reeenatamc/feuoir-interface/mediciones/2026-09-19-piso-con-guitarra-2/captura.png

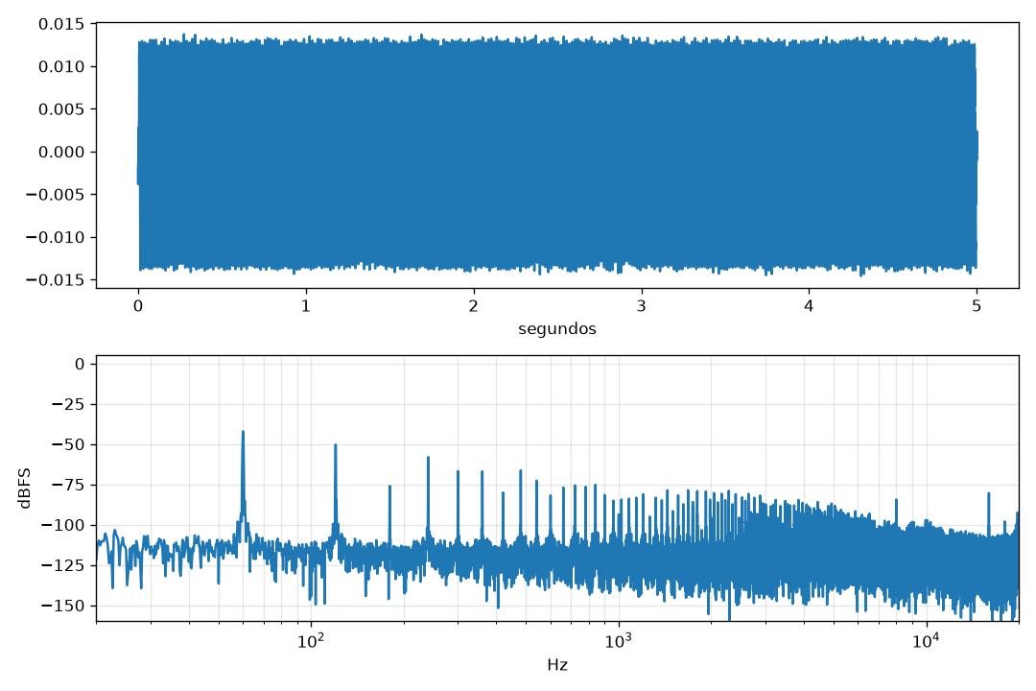
mediciones/2026-09-19-piso-con-guitarra-2/captura.png
