reeenatamc/feuoir-interface/mediciones/2026-09-19-piso-tarjeta-al-aire-3/captura.png

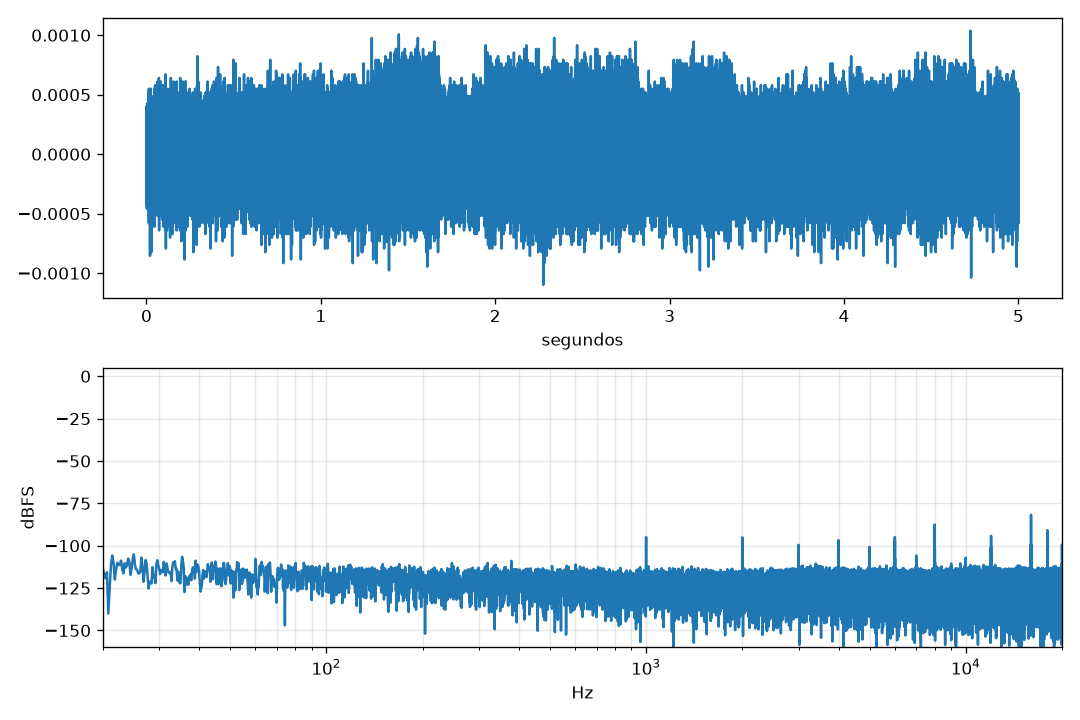
mediciones/2026-09-19-piso-tarjeta-al-aire-3/captura.png
