reeenatamc/feuoir-interface/mediciones/2026-09-19-piso-tarjeta-al-aire/captura.png

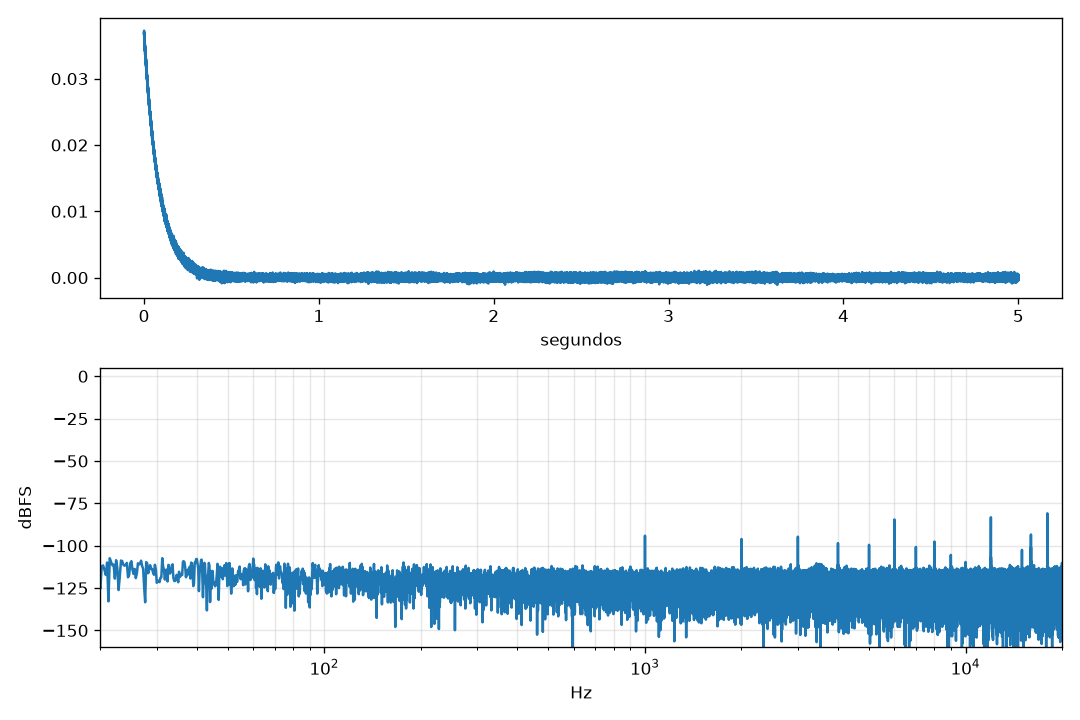
mediciones/2026-09-19-piso-tarjeta-al-aire/captura.png
