reeenatamc/feuoir-interface/mediciones/2026-09-19-rasgueo-fuerte-2/captura.png

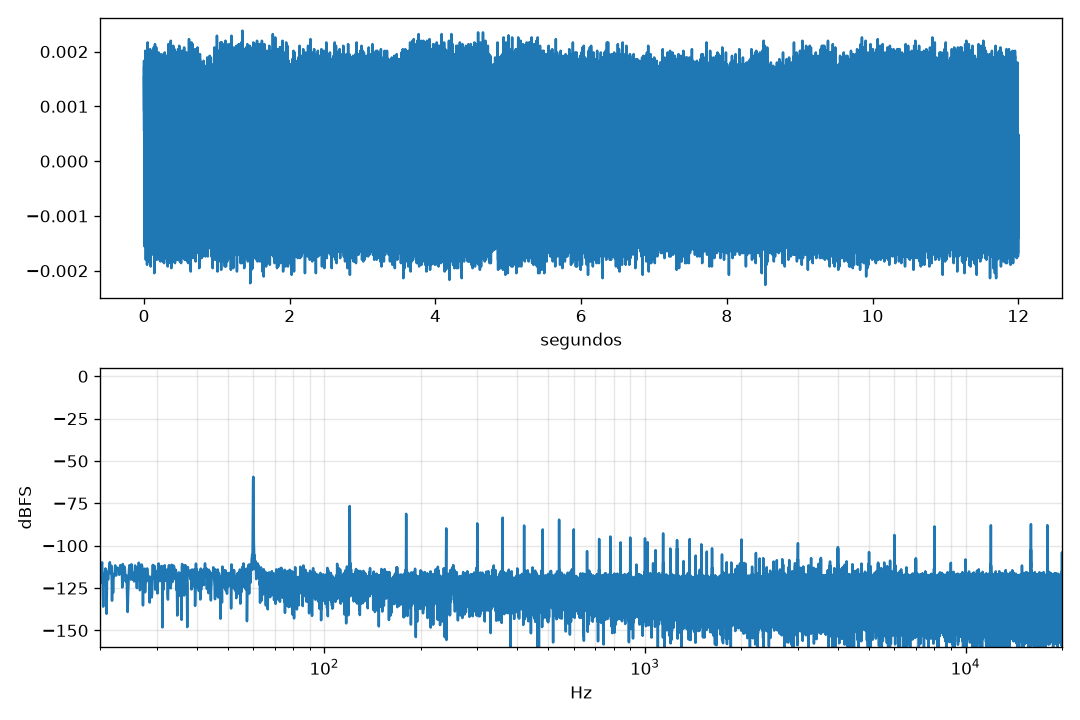
mediciones/2026-09-19-rasgueo-fuerte-2/captura.png
