reeenatamc/feuoir-interface/mediciones/2026-09-19-rasgueo-fuerte/captura.png

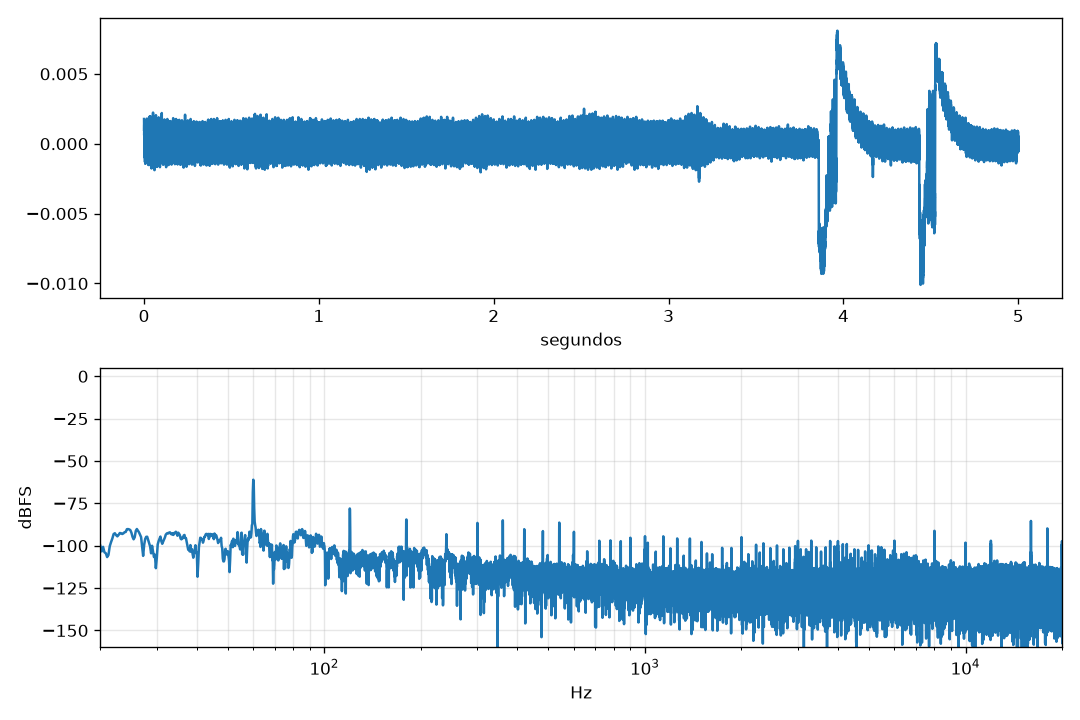
mediciones/2026-09-19-rasgueo-fuerte/captura.png
