reeenatamc/feuoir-interface/mediciones/2026-09-19-rasgueo-suave/captura.png

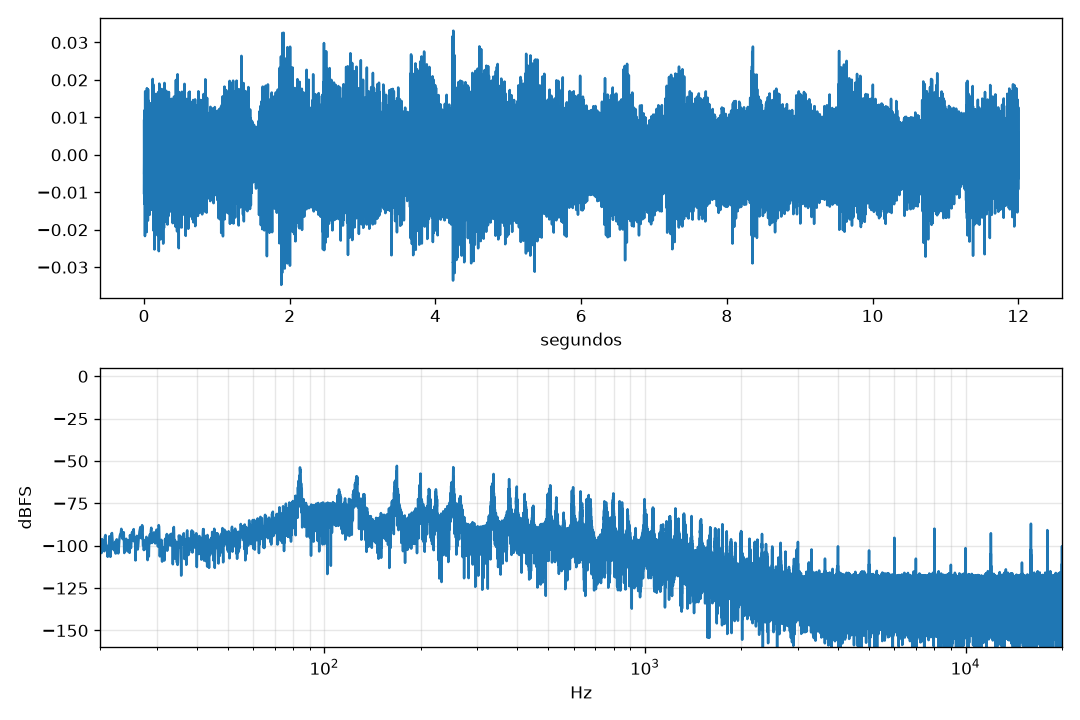
mediciones/2026-09-19-rasgueo-suave/captura.png
