reeenatamc/feuoir-interface/mediciones/2026-09-19-selector-4-con-golpes/captura.png

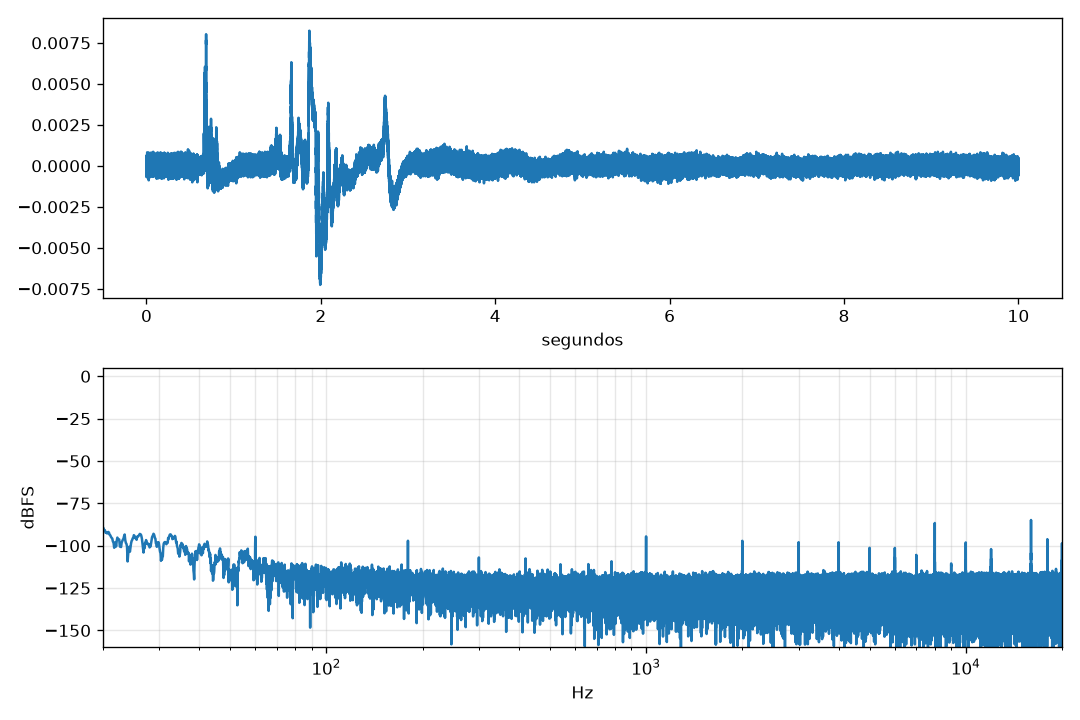
mediciones/2026-09-19-selector-4-con-golpes/captura.png
