reeenatamc/feuoir-interface/mediciones/2026-09-19-selector-5/captura.png

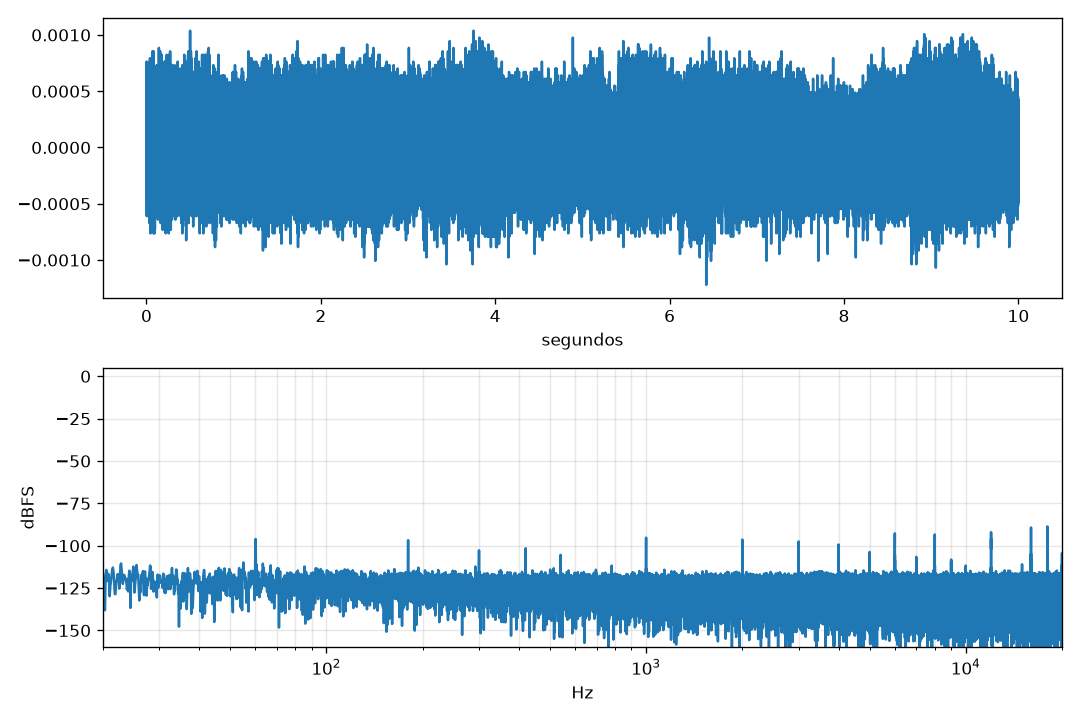
mediciones/2026-09-19-selector-5/captura.png
