reeenatamc/feuoir-interface/mediciones/2026-09-19-tono-usb-canal1-2/captura.png

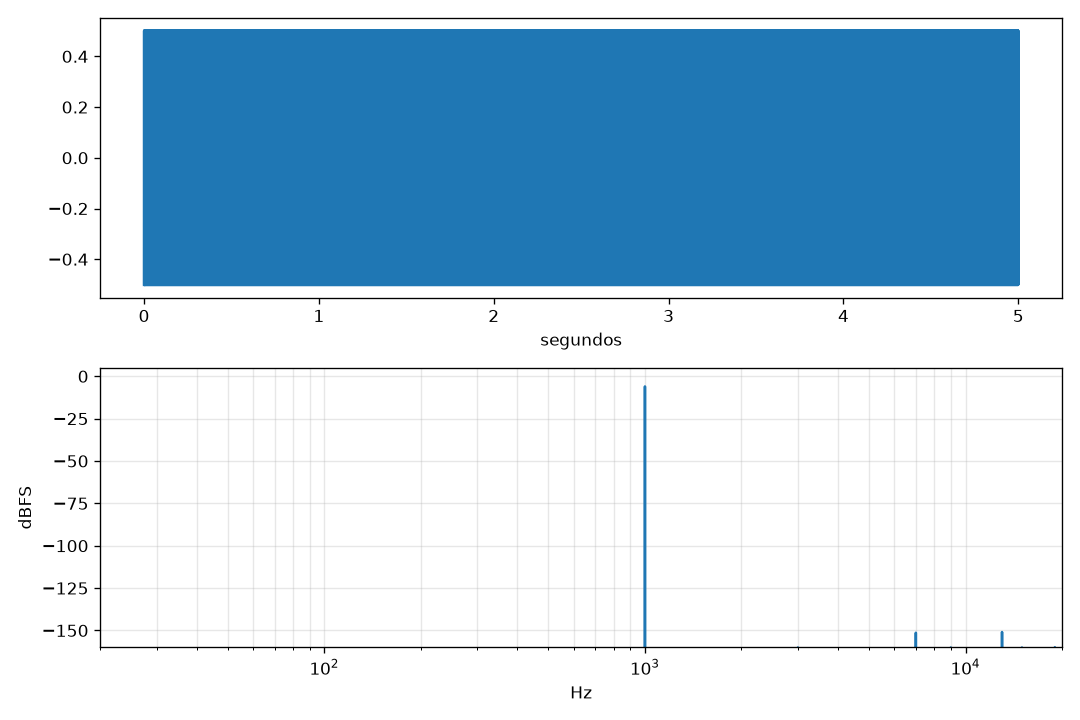
mediciones/2026-09-19-tono-usb-canal1-2/captura.png
