reeenatamc/feuoir-interface/mediciones/2026-09-19-tono-usb-canal2/captura.png

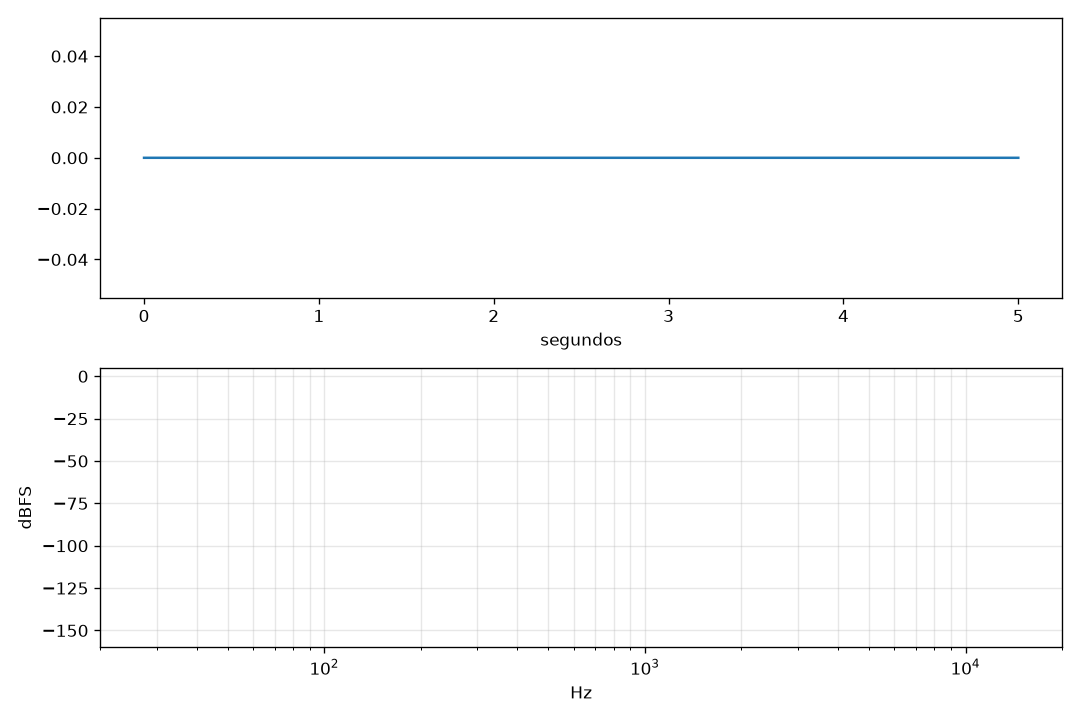
mediciones/2026-09-19-tono-usb-canal2/captura.png
