reeenatamc/feuoir-interface/mediciones/2026-09-19-toque-dulce/captura.png

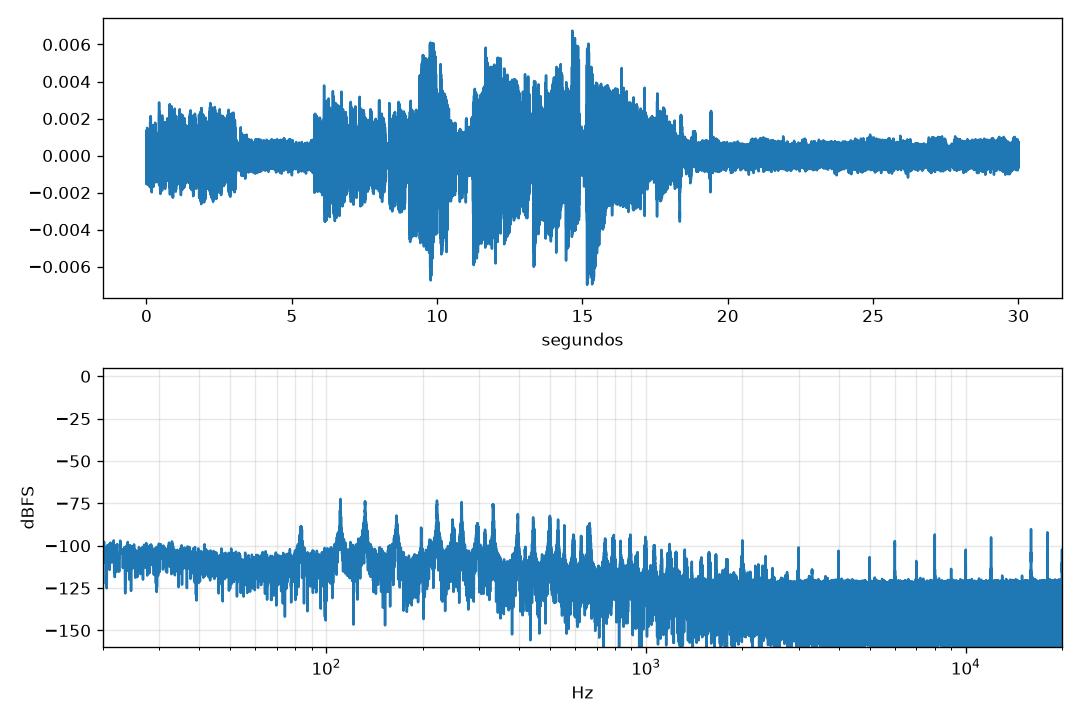
mediciones/2026-09-19-toque-dulce/captura.png
