reeenatamc/feuoir-interface/mediciones/2026-09-19-toque-libre/captura.png

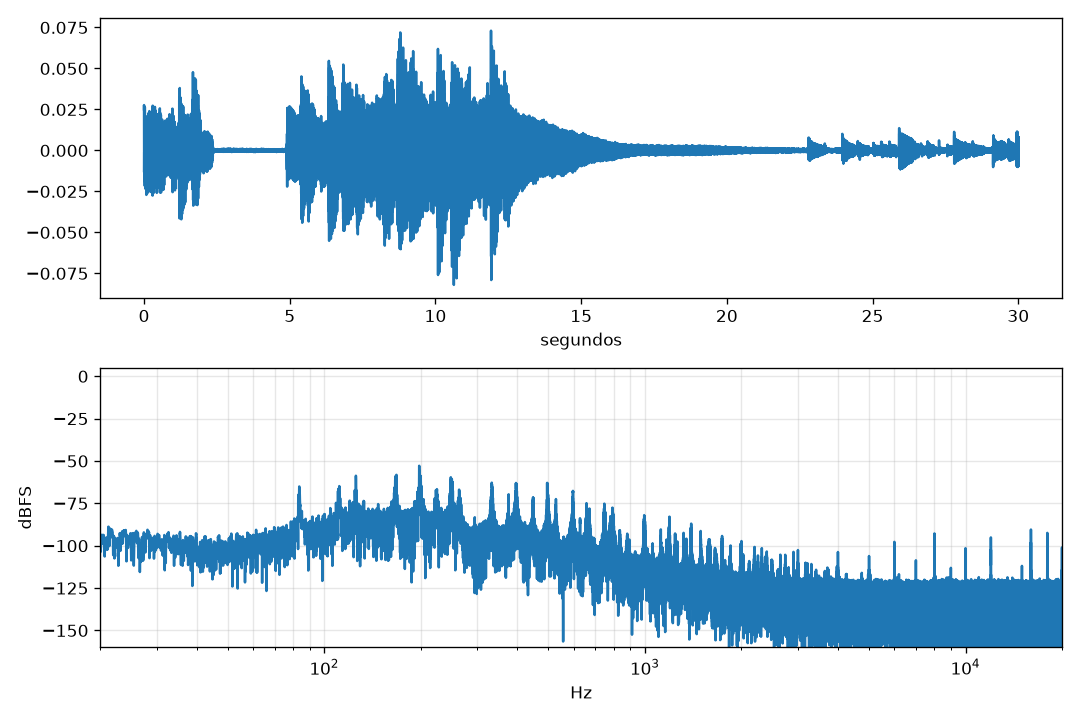
mediciones/2026-09-19-toque-libre/captura.png
