reeenatamc/feuoir-interface/mediciones/2026-09-23-sim-carga-guitarra/grafica.png

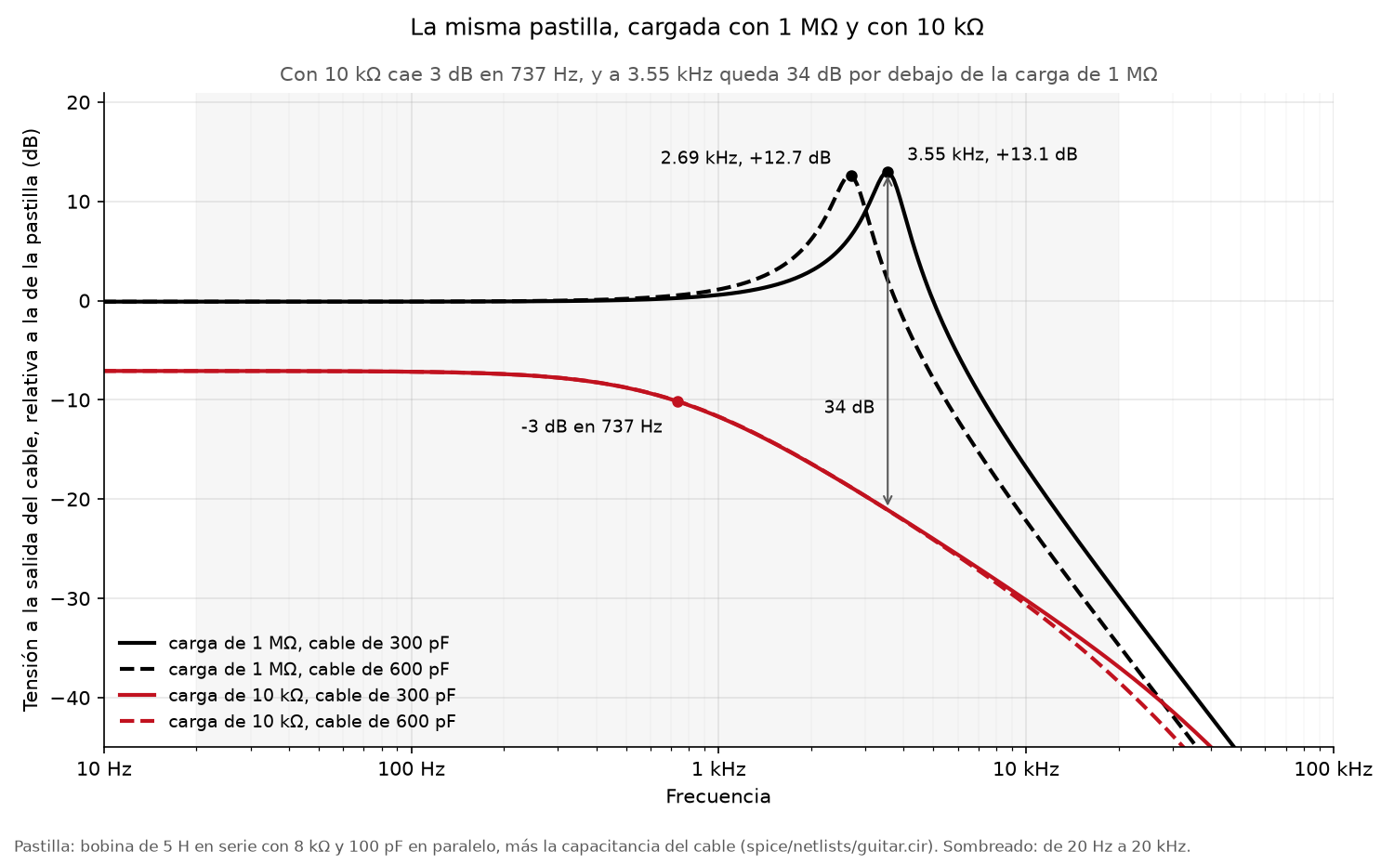
mediciones/2026-09-23-sim-carga-guitarra/grafica.png
