reeenatamc/feuoir-interface/mediciones/2026-09-23-sim-respuesta-en-frecuencia/grafica-partida.png

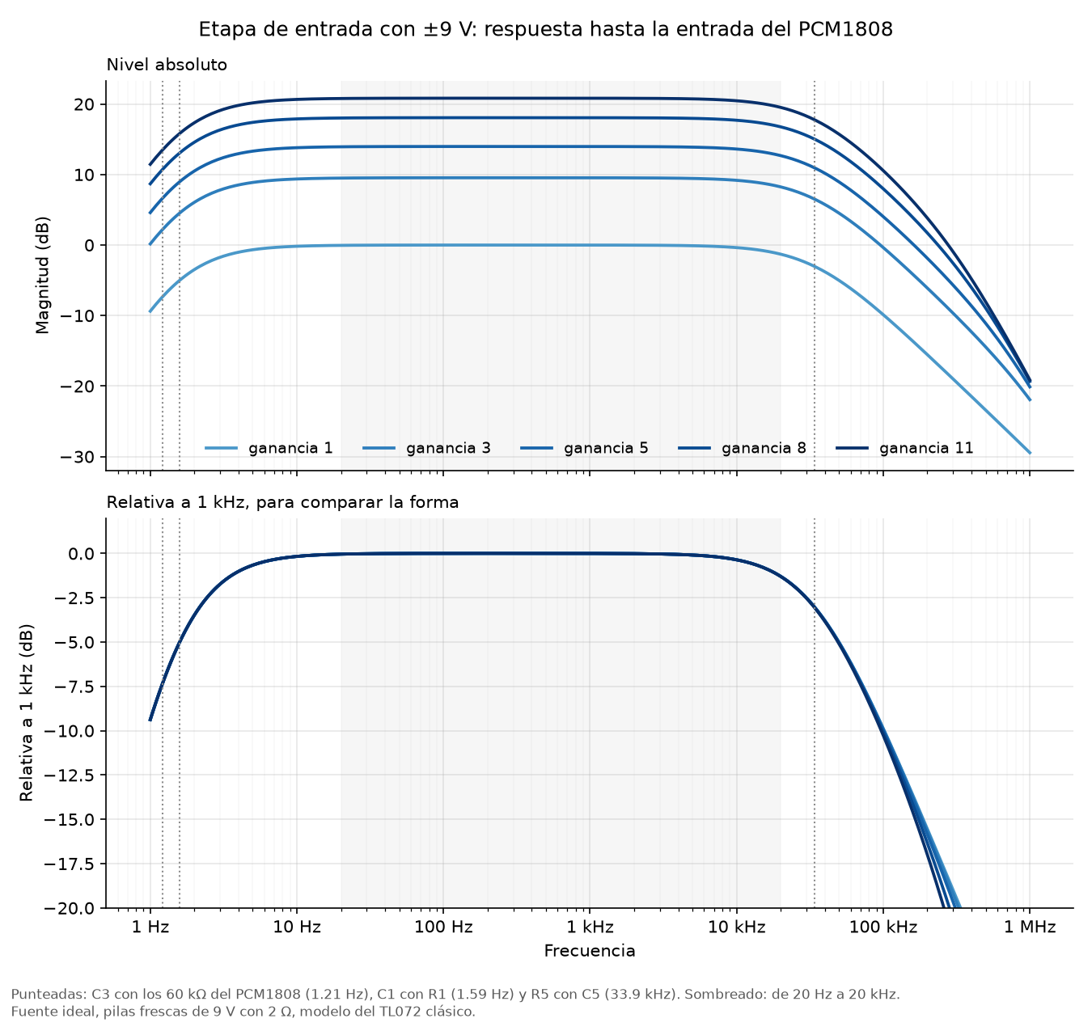
mediciones/2026-09-23-sim-respuesta-en-frecuencia/grafica-partida.png
