reeenatamc/feuoir-interface/mediciones/2026-09-23-sim-ruido/grafica.png

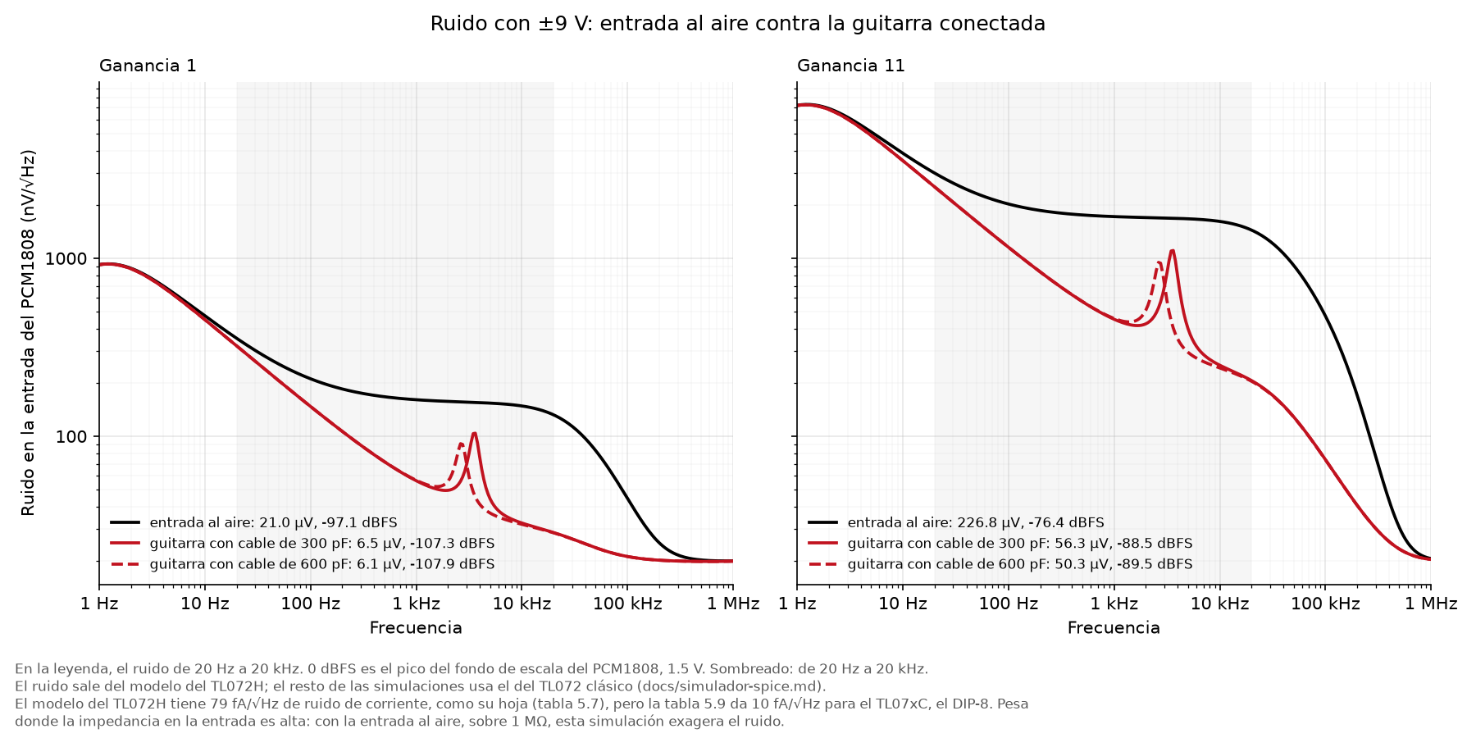
mediciones/2026-09-23-sim-ruido/grafica.png
