reeenatamc/feuoir-interface/mediciones/2026-09-23-sim-transitorio-1v5/grafica.png

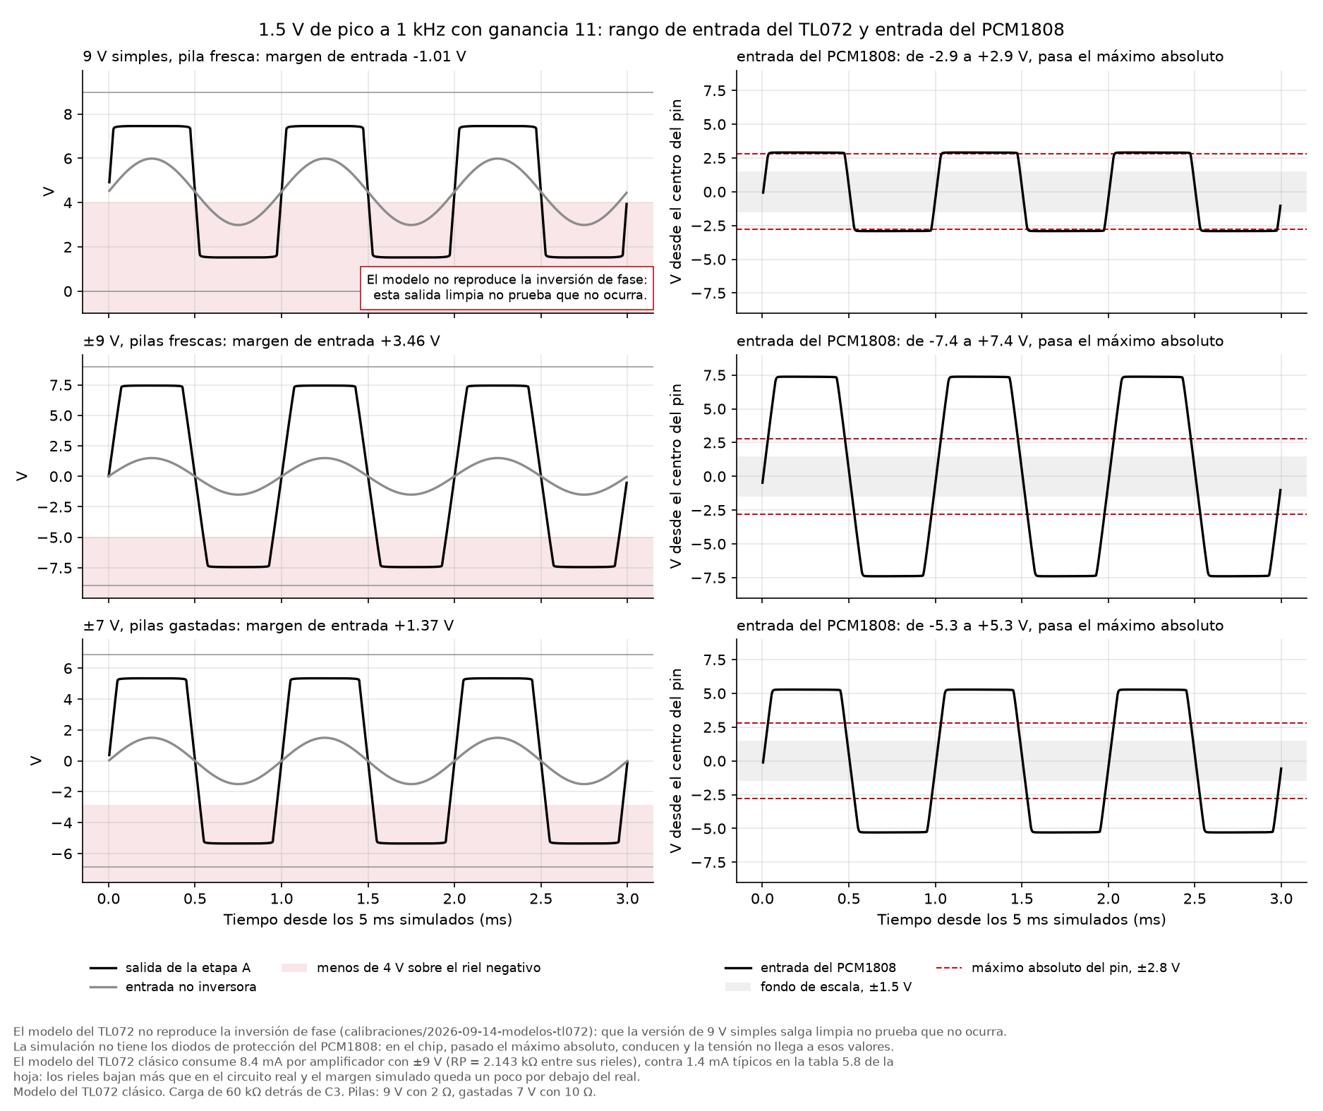
mediciones/2026-09-23-sim-transitorio-1v5/grafica.png
