reeenatamc/feuoir-interface/docs/armado/etapa_entrada_pasos.pdf

a b c d e | f g h i j

tierra

-9

tierra
+9

# Paso 1 de 21

## La piecita negra de ocho patitas

Pisando la zanja, patitas en las filas 14, 15, 16 y 17.

La muesca de media luna mira hacia el lado del 1.

Lo gris claro ya está puesto. Cuenta las filas desde la punta donde la tabla dice 1.

Los agujeritos de las cuatro tiras de los bordes no coinciden con los números: toda una tira es un mismo punto, así que en ellas sirve cualquier agujerito.

1

2

3

4 | 5
| 6

7

8

1 1

2 | 2
3 | 3
4 | 4
5 5
6 | 6
7 | 7
8 | 8
9 | 9
10 10
11 11
12 | 12
13 | 13
14 14
15 15
16 16
17 17
18 | 18
19 | 19
20 20
21 | 21
22 22
23 | 23
24 24
25 25
26 26
27 | 27
28 | 28
29 | 29
30 30

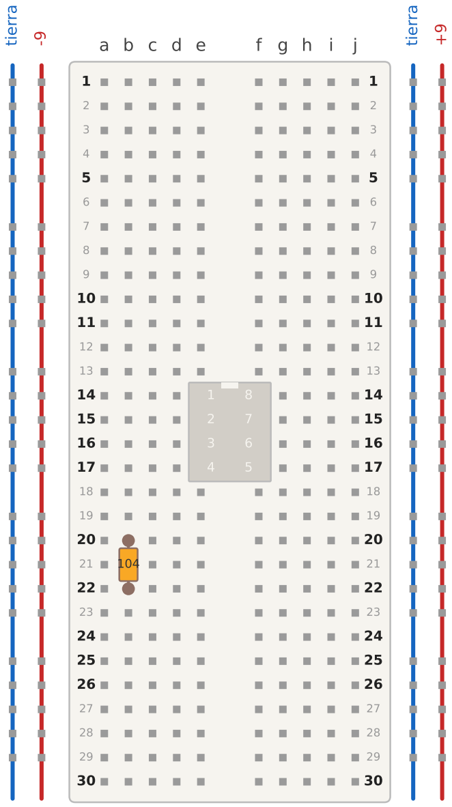
[picture p26: figure]
tierra

impreso en la cara

### así se ve la lentejita de este paso

# Paso 2 de 21

## Lentejita con 104 impreso

Una patita en b22 y la otra en b20.
No tiene lado, da igual cuál patita va en cuál.

104

a b c d e | f g h i j

tierra

-9

tierra
+9

café

negro

# negro amarillo

café

# si tiene 5 rayitas café negro verde dorada

si tiene 4 rayitas

### así se ve el tubito de este paso

# Paso 3 de 21

## Tubito de la tira que dice 1M

Una patita en c20 y la otra en c24.

No tiene lado.

1

2

3

4 | 5
| 6

7

8

1 1

2 | 2
3 | 3
4 | 4
5 5
6 | 6
7 | 7
8 | 8
9 | 9
10 10
11 11
12 | 12
13 | 13
14 14
15 15
16 16
17 17
18 | 18
19 | 19
20 20
21 | 21
22 22
23 | 23
24 24
25 25
26 26
27 | 27
28 | 28
29 | 29
30 30

a b c d e | f g h i j

tierra

-9

tierra
+9

café

negro

negro café
café

# si tiene 5 rayitas café negro rojo dorada

si tiene 4 rayitas

### así se ve el tubito de este paso

# Paso 4 de 21

## Tubito de la tira que dice 1K

Una patita en c15 y la otra en c11.

No tiene lado.

1

2

3

4 | 5
| 6

7

8

1 1

2 | 2
3 | 3
4 | 4
5 5
6 | 6
7 | 7
8 | 8
9 | 9
10 10
11 11
12 | 12
13 | 13
14 14
15 15
16 16
17 17
18 | 18
19 | 19
20 20
21 | 21
22 22
23 | 23
24 24
25 25
26 26
27 | 27
28 | 28
29 | 29
30 30

a b c d e | f g h i j

tierra

-9

tierra
+9

amarillo

violeta
negro café
café

# si tiene 5 rayitas amarillo violeta rojo dorada

si tiene 4 rayitas

### así se ve el tubito de este paso

# Paso 5 de 21

## Tubito de la tira que dice 4K7

Una patita en h20 y la otra en h24.

No tiene lado.

1

2

3

4 | 5
| 6

7

8

1 1

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

# Paso 6 de 21

## Lentejita con 102 impreso

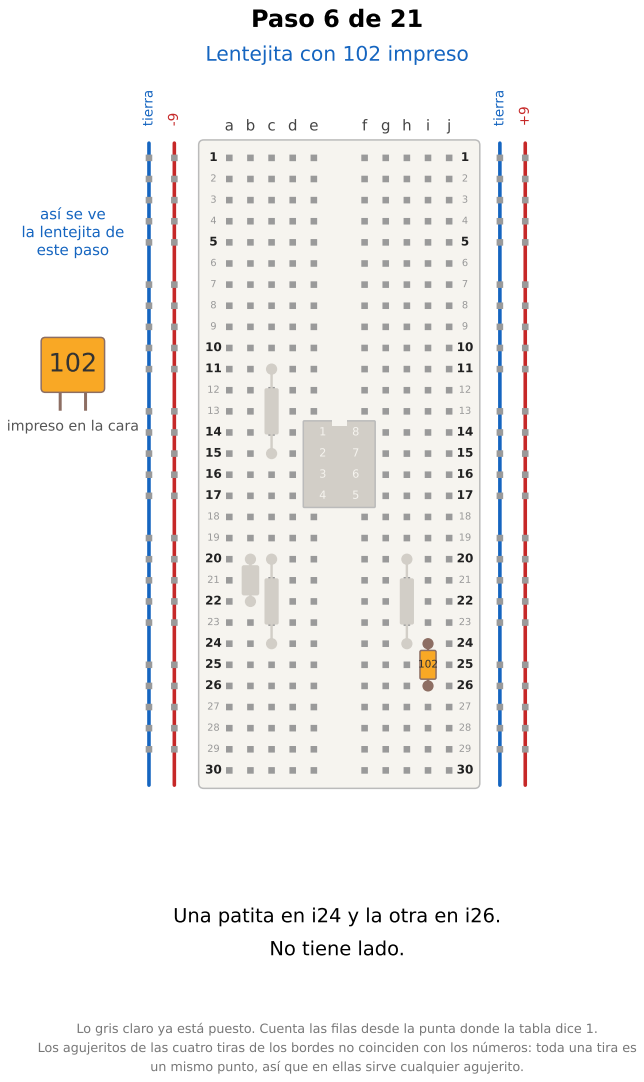
[picture p27: page 6]
tierra

así se ve
la lentejita de
este paso

impreso en la cara

Una patita en i24 y la otra en i26.

No tiene lado.

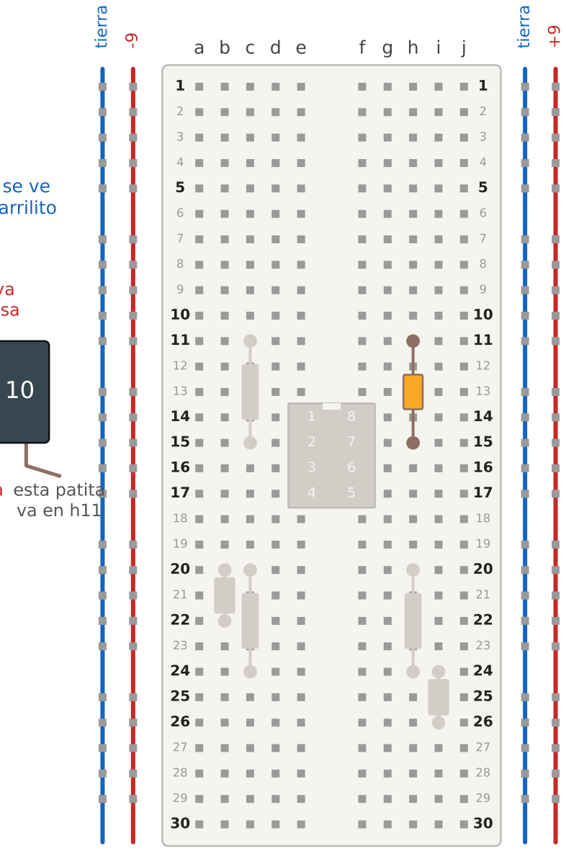
[picture p28: figure]
tierra; esta patita va en h11

esta patita
va en h15

la raya
impresa

### así se ve el barrilito

# Paso 7 de 21

## El barrilito de 10 µF

## Va de h15 a h11, y SÍ tiene lado: la patita del lado

de la raya impresa va en h15, la otra en h11.

# Paso 8 de 21

## Cable corto

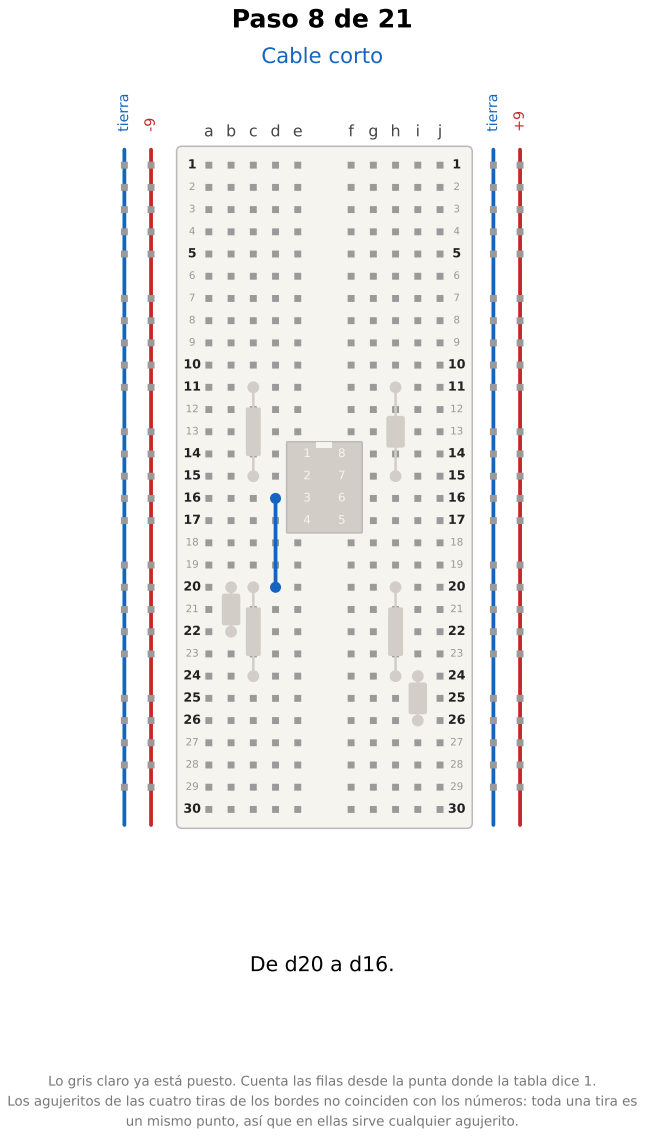
[picture p29: page 8]
tierra

# Paso 9 de 21

## Cable

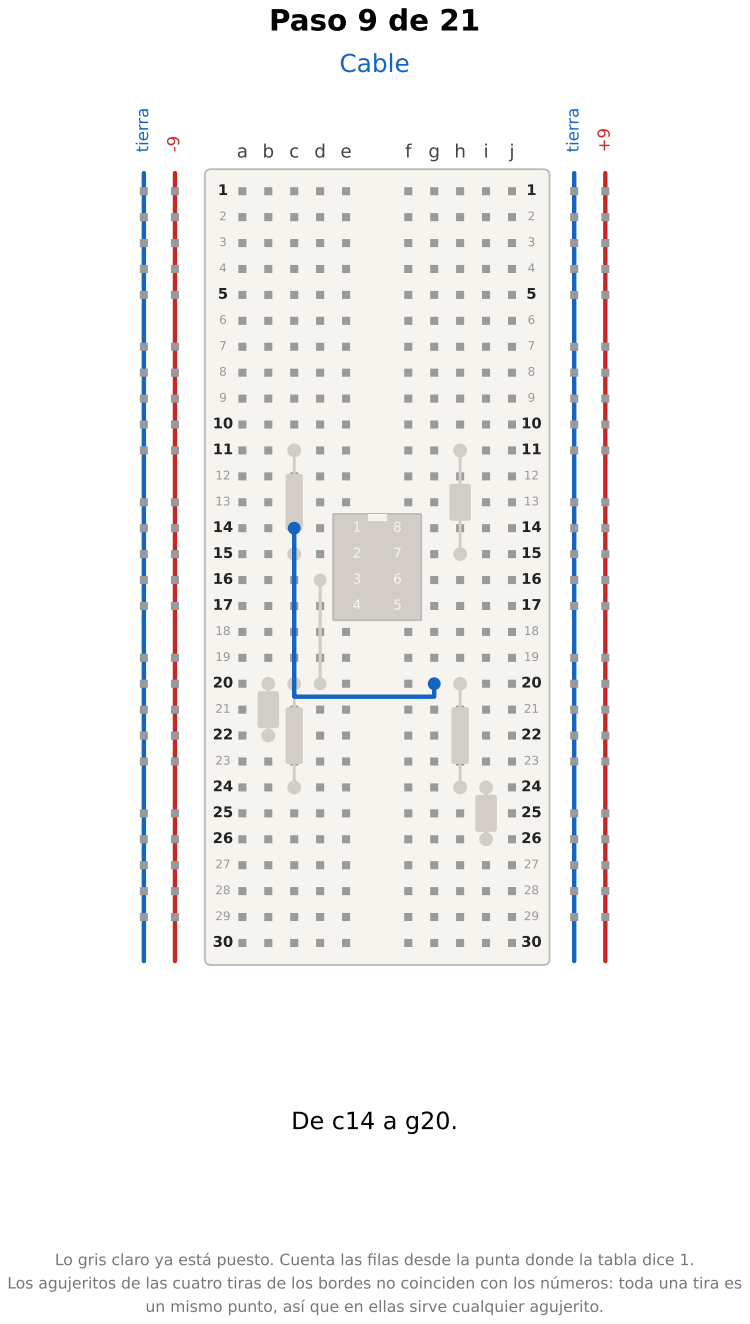
[picture p30: page 9]
tierra

# Paso 10 de 21

## Cable

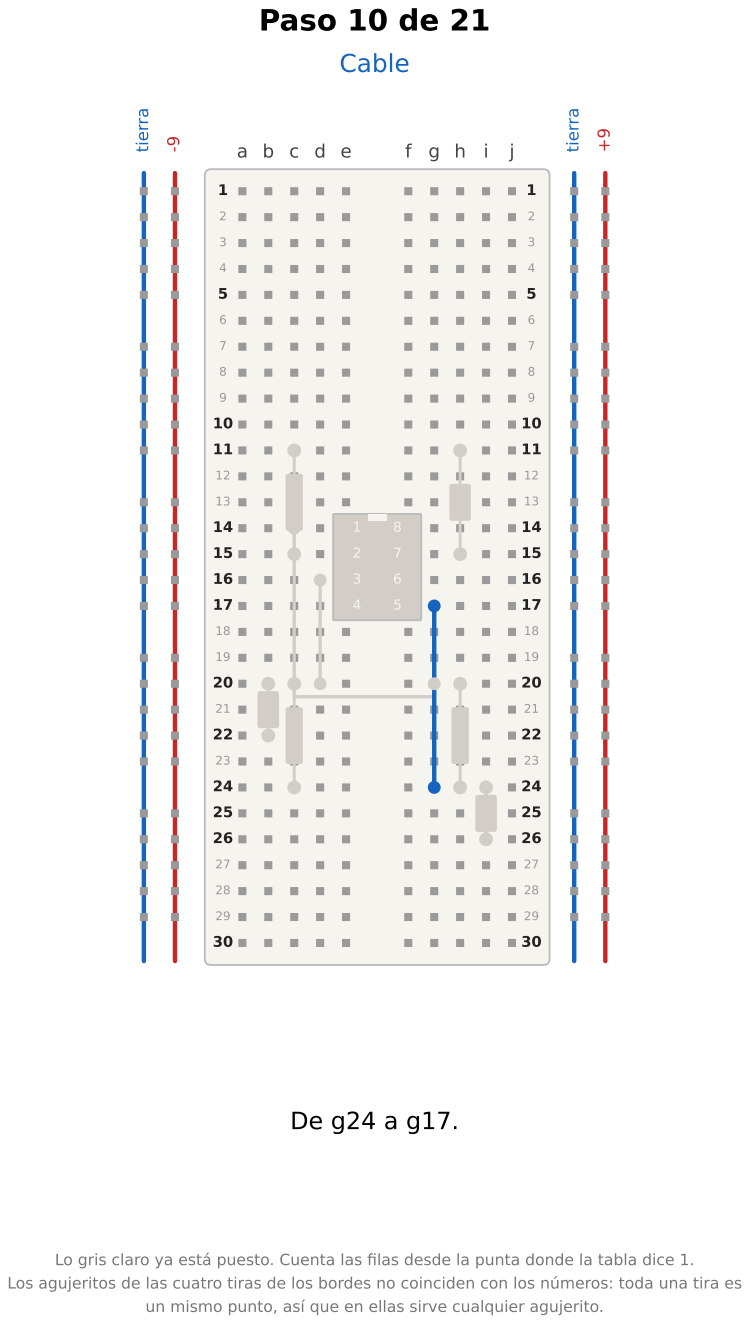
[picture p31: page 10]
tierra

# Paso 11 de 21

## Cable cortito

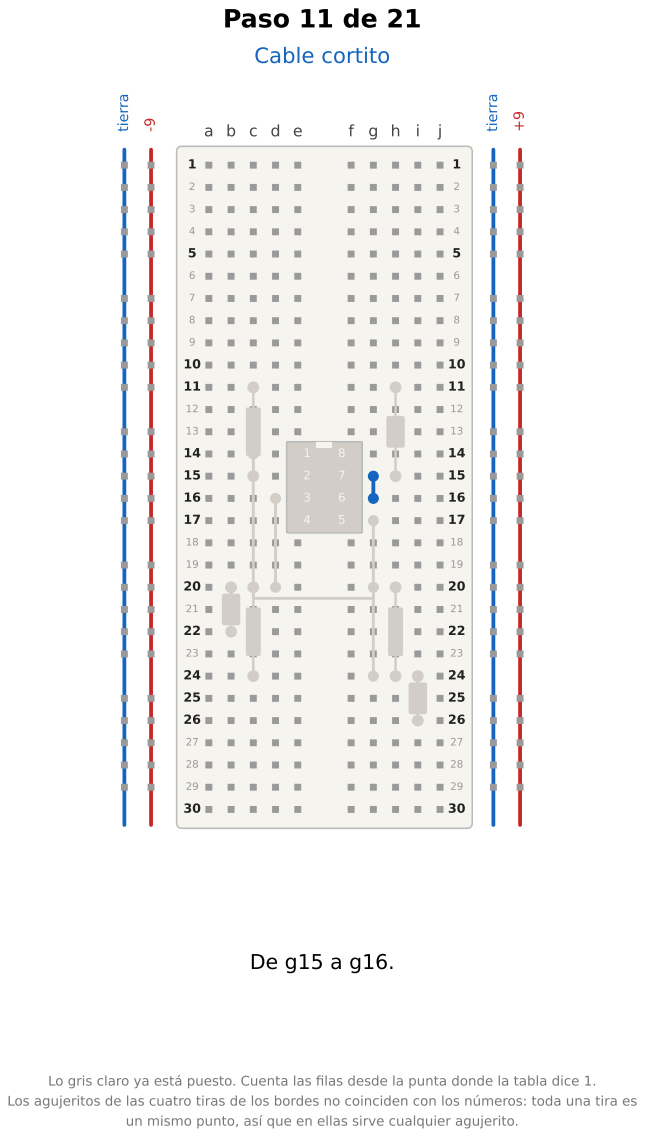
[picture p32: page 11]
tierra

a b c d e | f g h i j

tierra

-9

tierra
+9

# Paso 12 de 21

## Cable a una tira del borde

De a24 a la tira AZUL del lado de las letras a b c d e. Sirve cualquier agujerito de esa tira: usa uno cerca de la fila 24.

1

2

3

4 | 5
| 6

7

8

1 1

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

# Paso 13 de 21

## Cable a una tira del borde

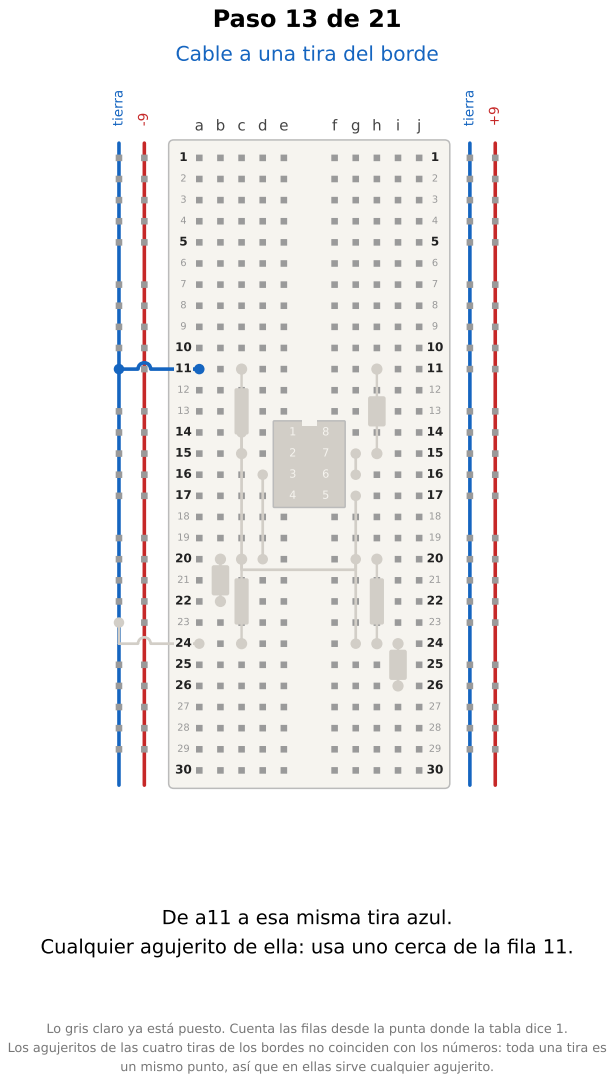
[picture p33: page 13]
tierra

De a11 a esa misma tira azul.

Cualquier agujerito de ella: usa uno cerca de la fila 11.

a b c d e | f g h i j

tierra

-9

tierra
+9

# Paso 14 de 21

## Cable a una tira del borde

De j26 a la tira AZUL del lado de las letras f g h i j. Cualquier agujerito de ella: usa uno cerca de la fila 26.

1

2

3

4 | 5
| 6

7

8

1 1

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

a b c d e | f g h i j

tierra

-9

tierra
+9

# Paso 15 de 21

## Cable a una tira del borde

De g14 a la tira ROJA del lado de las letras f g h i j. Cualquier agujerito de ella: usa uno cerca de la fila 14.

1

2

3

4 | 5
| 6

7

8

1 1

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

a b c d e | f g h i j

tierra

-9

tierra
+9

# Paso 16 de 21

## Cable a una tira del borde

De d17 a la tira ROJA del lado de las letras a b c d e. Cualquier agujerito de ella: usa uno cerca de la fila 17.

1

2

3

4 | 5
| 6

7

8

1 1

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

a b c d e | f g h i j

tierra

-9

tierra
+9

# Paso 17 de 21

## Cable largo que une las dos tiras de tierra

Un cable largo de una tira azul a la otra tira azul, por debajo de la tabla. Cualquier agujerito de cada una.

1

2

3

4 | 5
| 6

7

8

1 1

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

# Paso 18 de 21

## Dos lentejitas más con 104 impreso

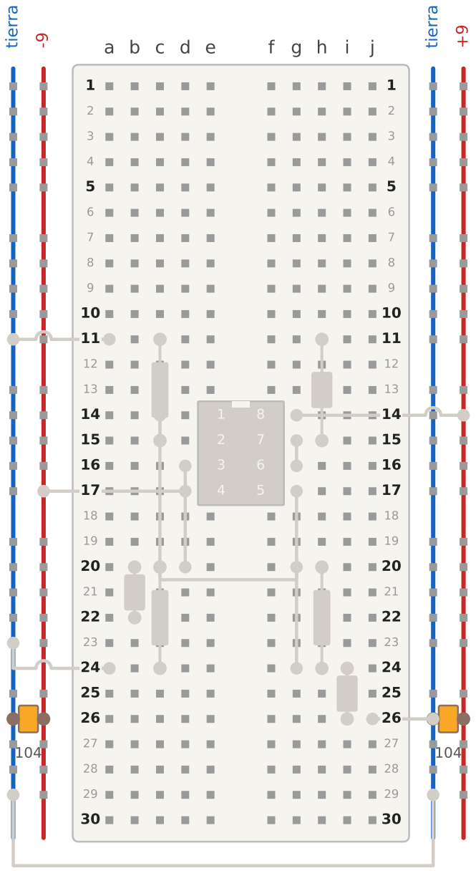
[picture p34: figure]
tierra

## Una con una patita en la tira roja y la otra en la azul

del mismo costado. Lo mismo con la otra, en el otro costado.

# Paso 19 de 21

## La perilla que gira, clavada en la tabla

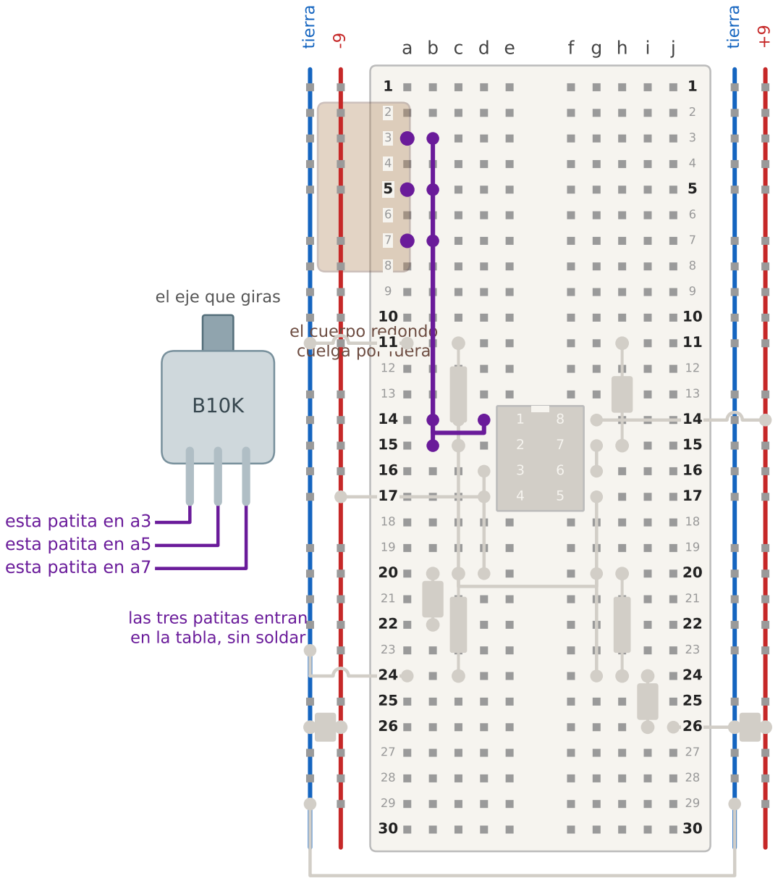
[picture p35: figure]
tierra; cuerpo redondo; cuelga por fuera; el eje que giras; esta patita en a3 esta patita en a5 esta patita en a7; las tres patitas entran en la tabla, sin soldar

## Sus tres patitas en a3, a5 y a7, con el cuerpo redondo colgando

hacia afuera de la tabla, para que no tape las letras b c d e.

## Luego tres cables: b3 a b14, b5 a d14 y b7 a b15. Si el cuerpo

tapa alguno, usa c, d o e de esa misma fila, es el mismo punto.

Si no quieres perilla: un tubito de a14 a b15 y nada más. Lo gris claro ya está puesto. Cuenta las filas desde la punta donde la tabla dice 1.

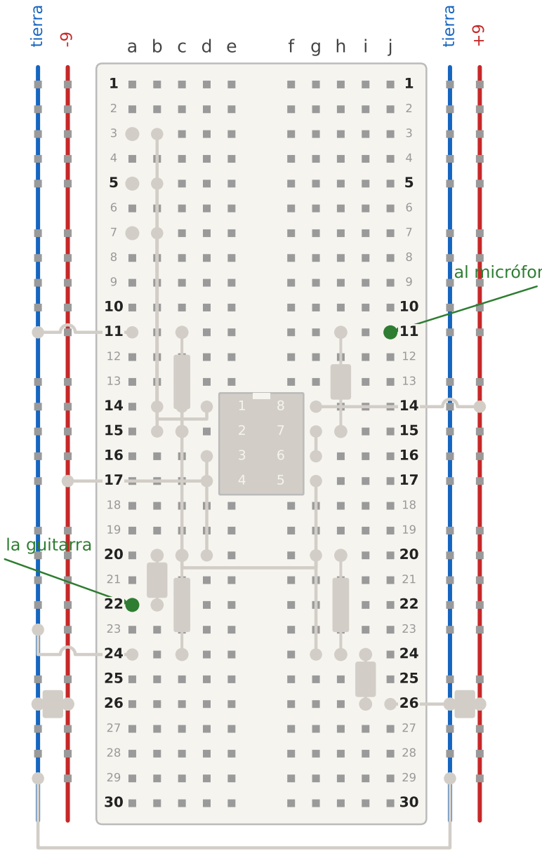
[picture p36: figure]
tierra

punta del cable de la guitarra al micrófono de la tarjeta USB

# Paso 20 de 21

## La guitarra entra y la señal sale

Vivo de la guitarra a a22, su malla a una tira de tierra. Salida j11 al cable de la tarjeta, su malla a tierra.

# Paso 21 de 21

## Las cajitas con pilas, AL FINAL Y APAGADAS

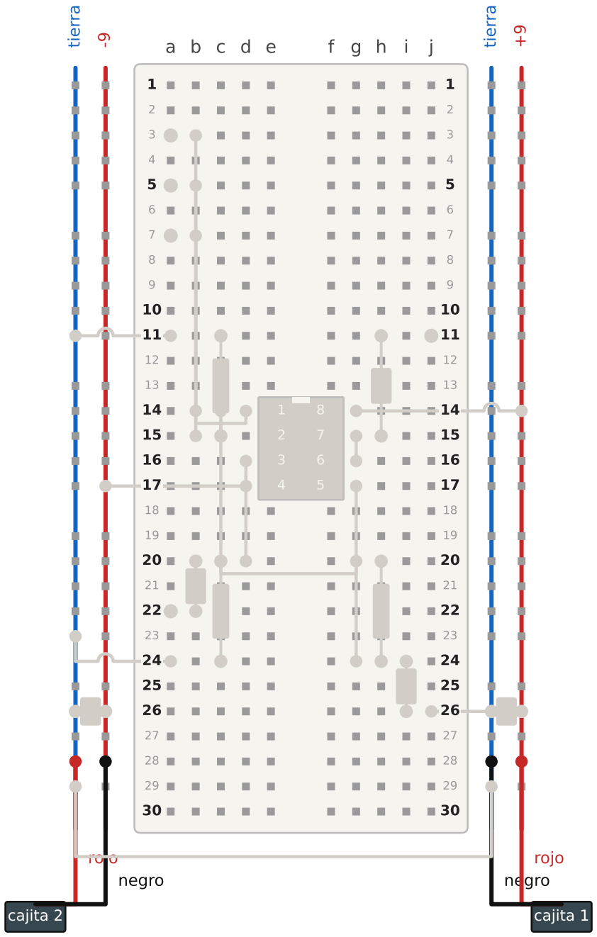
[picture p37: figure]
tierra; rojo; negro; cajita 2; cajita 1

Cajita 1: rojo a la tira de +9, negro a la tierra de ese lado. Cajita 2: rojo a la tierra del otro lado, negro a la de -9.
