reeenatamc/feuoir-interface/docs/armado/etapa2.png

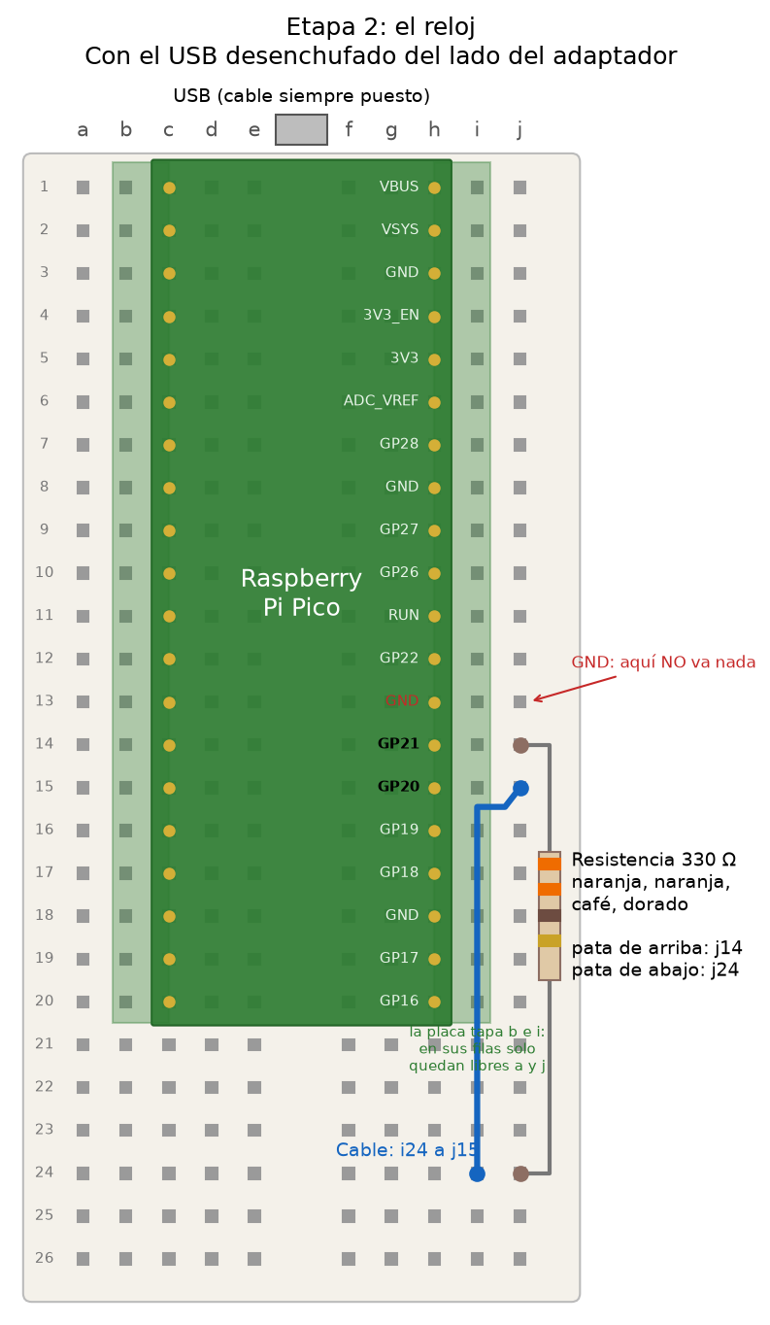
docs/armado/etapa2.png
