reeenatamc/feuoir-interface/docs/armado/etapa2_sobre_la_foto.jpg

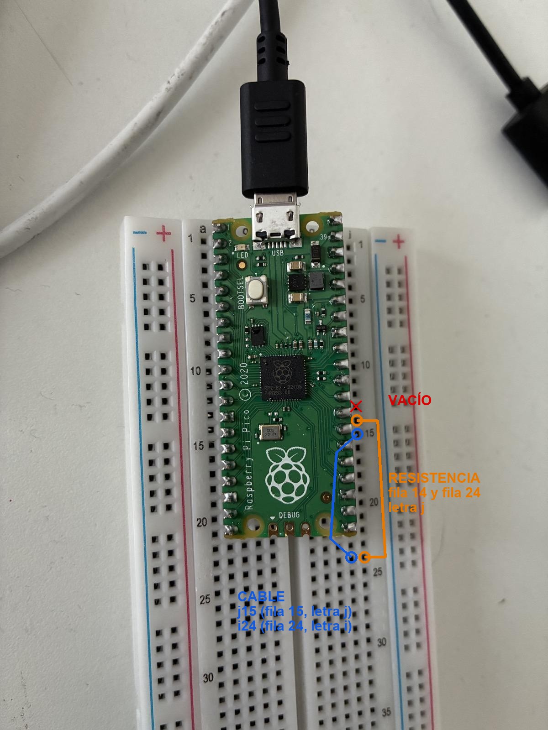
docs/armado/etapa2_sobre_la_foto.jpg
