reeenatamc/feuoir-interface/docs/armado/etapa_entrada_alimentacion.png

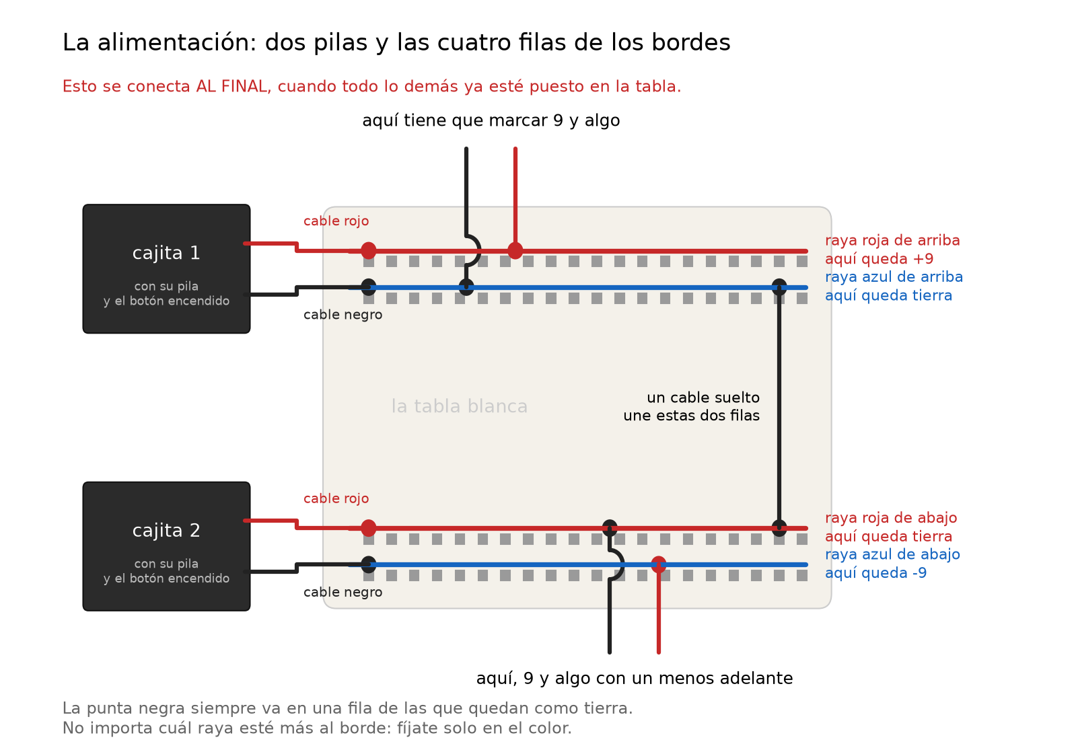
docs/armado/etapa_entrada_alimentacion.png
