reeenatamc/feuoir-interface/docs/armado/etapa_entrada_protoboard.png

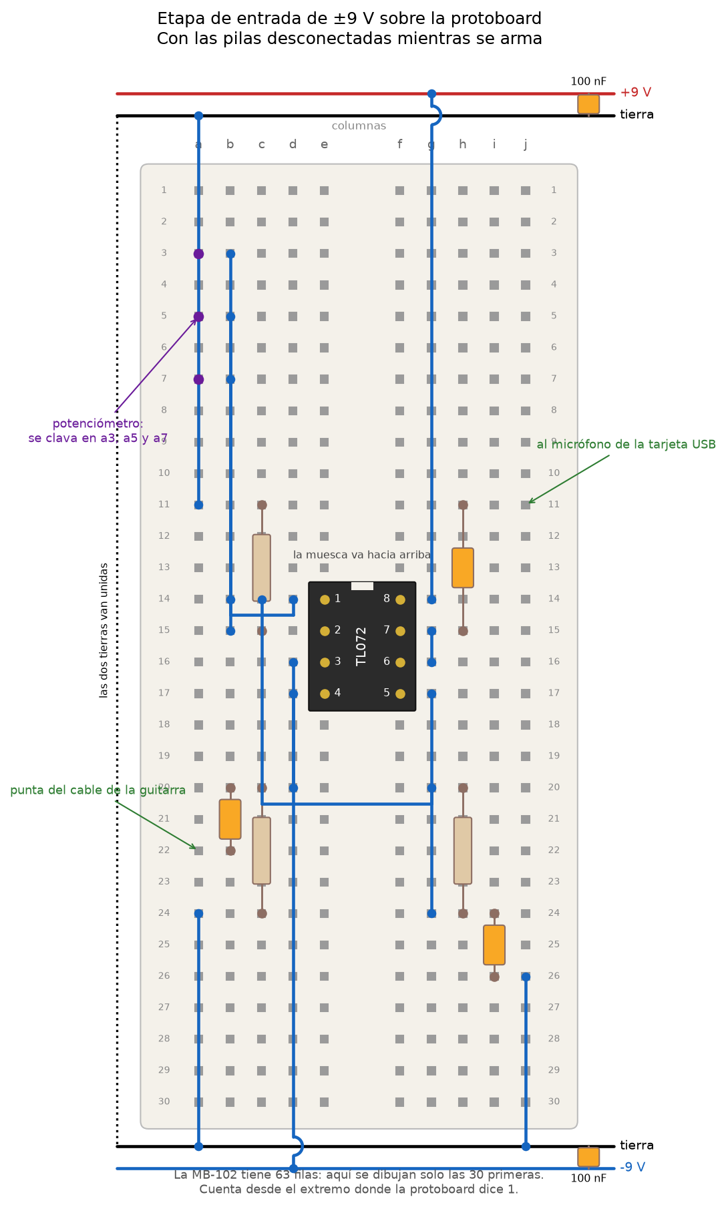
docs/armado/etapa_entrada_protoboard.png
