reeenatamc/feuoir-interface/docs/armado/pasos/paso_01.png

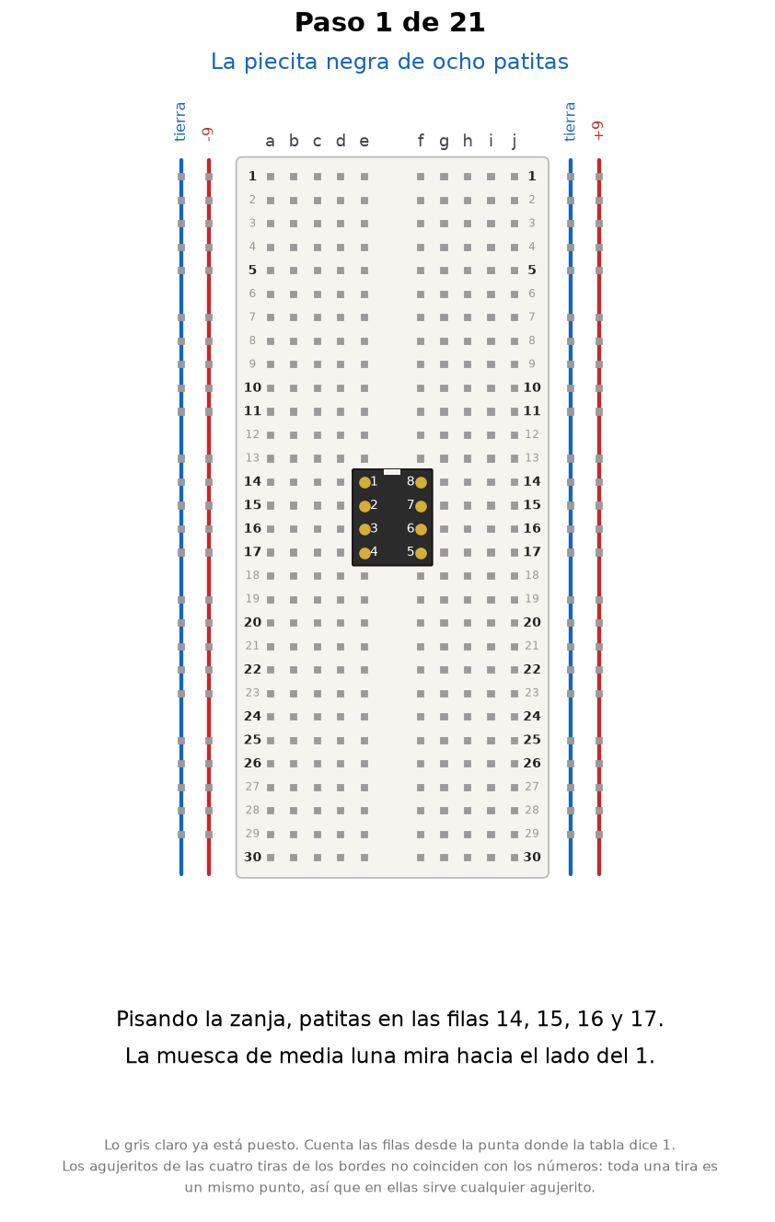
docs/armado/pasos/paso_01.png
