reeenatamc/feuoir-interface/docs/armado/pasos/paso_03.png

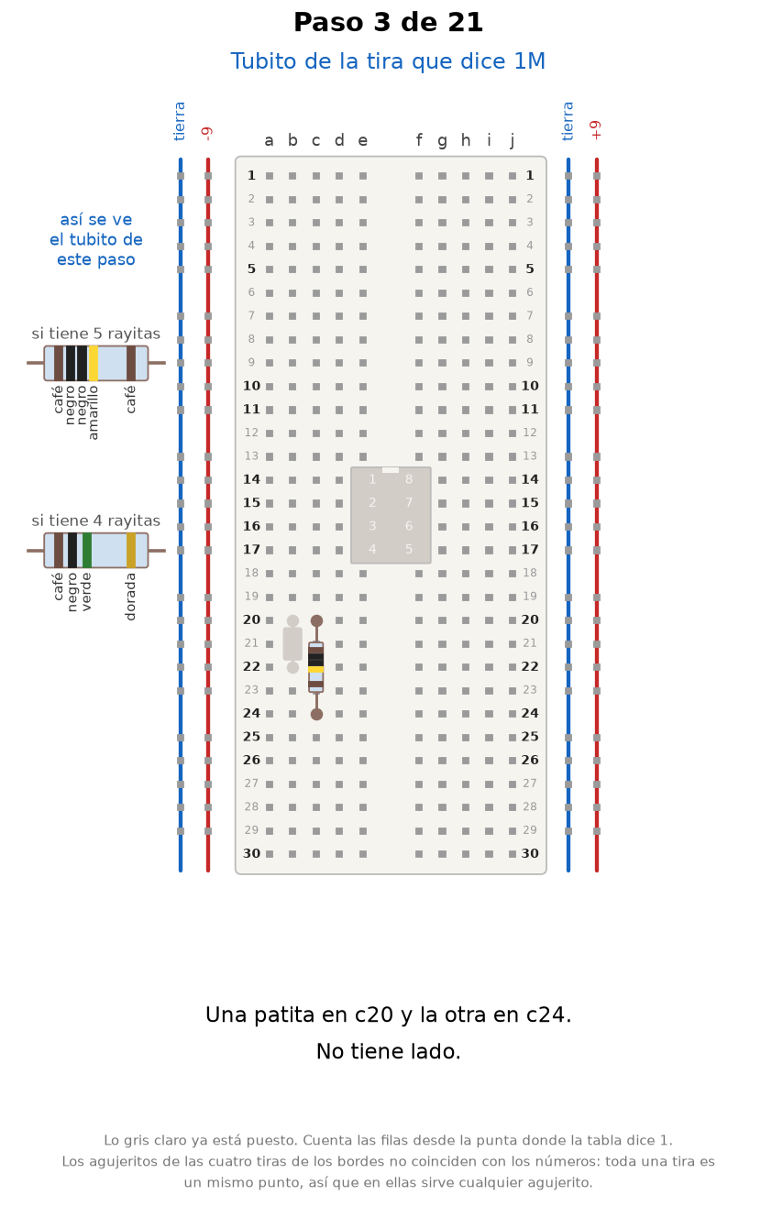
docs/armado/pasos/paso_03.png
