reeenatamc/feuoir-interface/docs/armado/pasos/paso_07.png

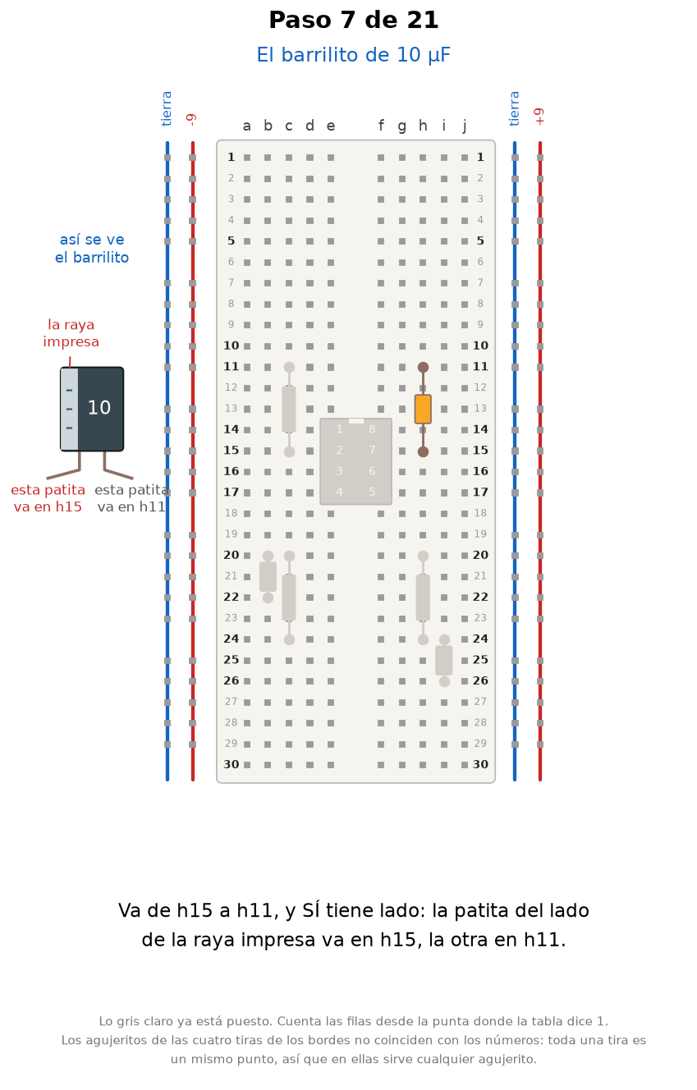
docs/armado/pasos/paso_07.png
