reeenatamc/feuoir-interface/docs/armado/pasos/paso_08.png

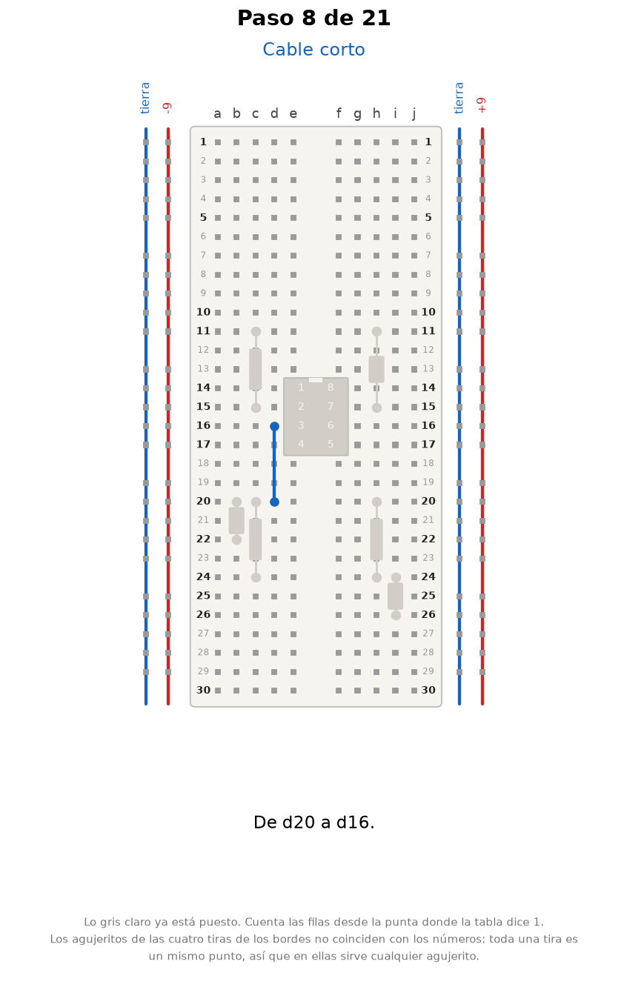
docs/armado/pasos/paso_08.png
