reeenatamc/feuoir-interface/docs/armado/pasos/paso_14.png

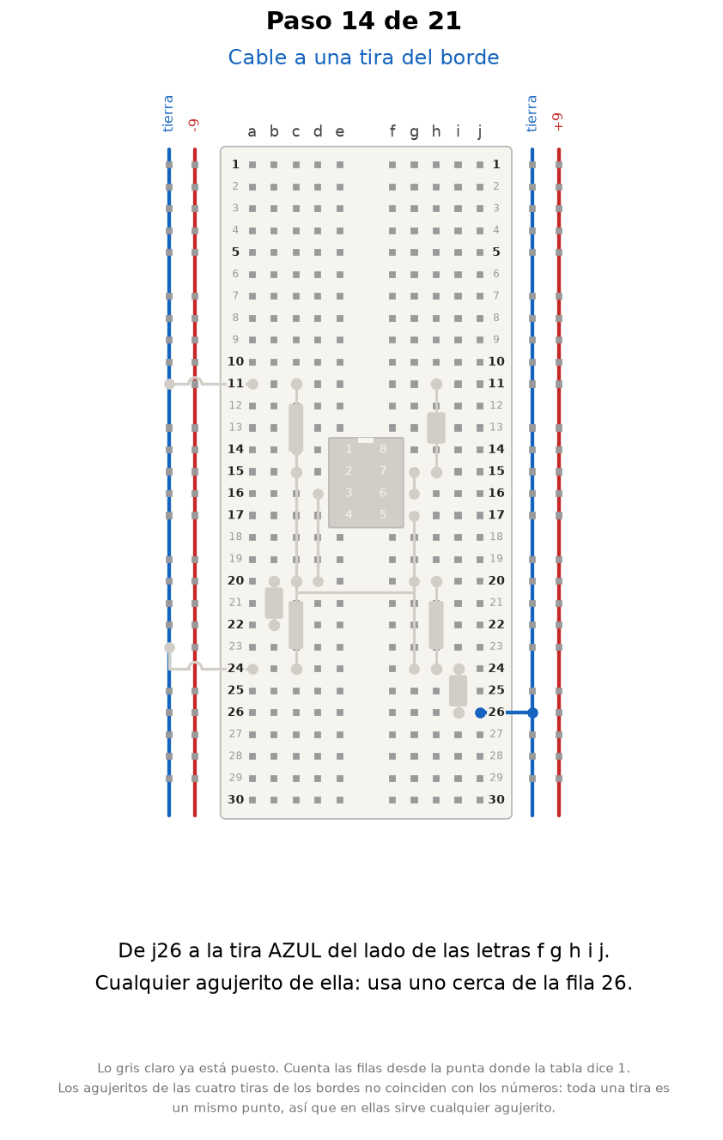
docs/armado/pasos/paso_14.png
