reeenatamc/feuoir-interface/docs/armado/pasos/paso_19.png

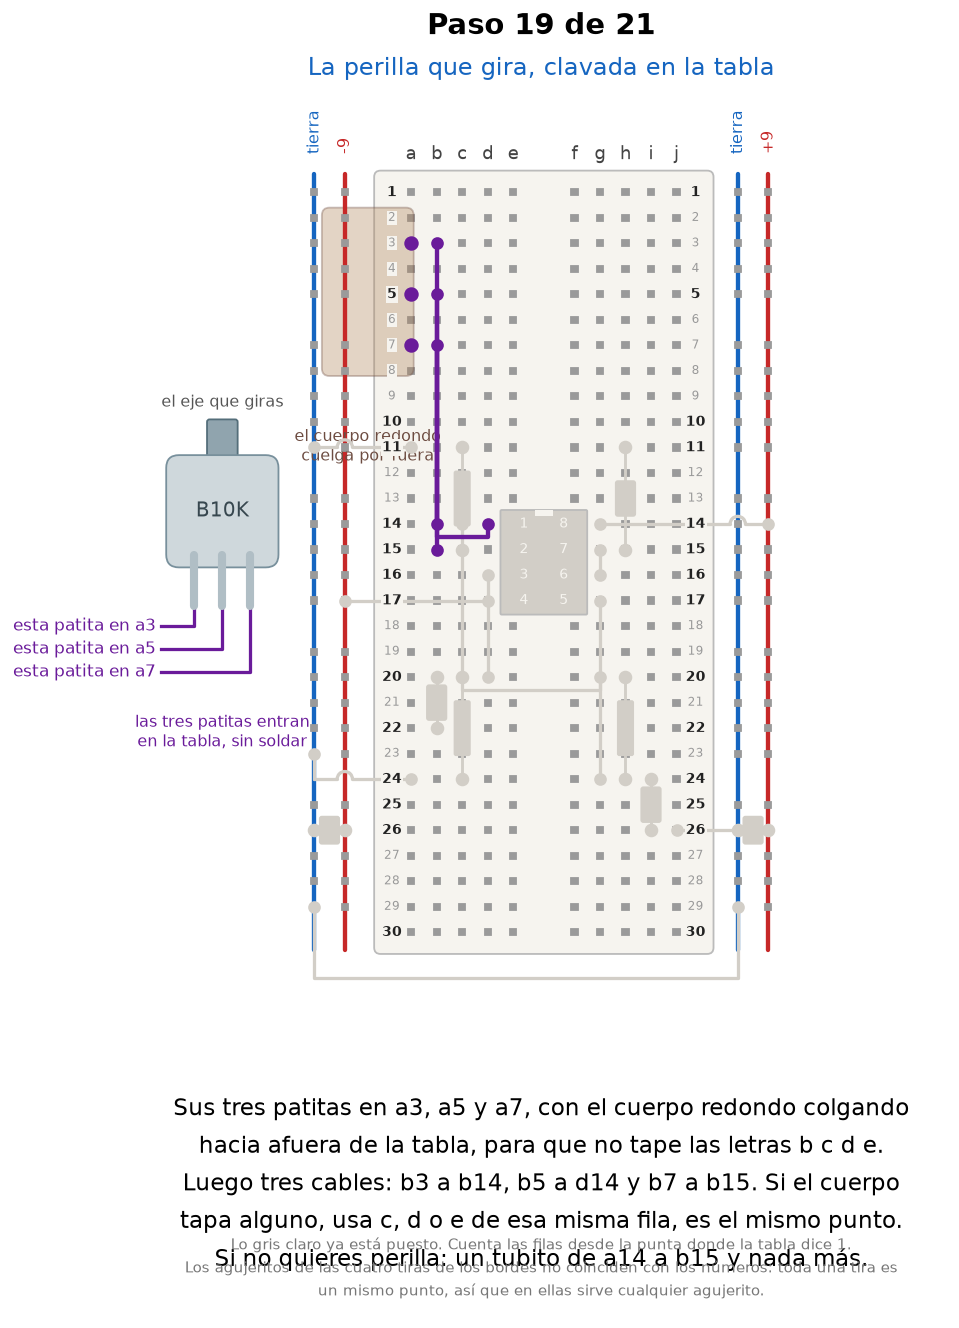
docs/armado/pasos/paso_19.png
