reeenatamc/feuoir-interface/docs/armado/pasos/paso_20.png

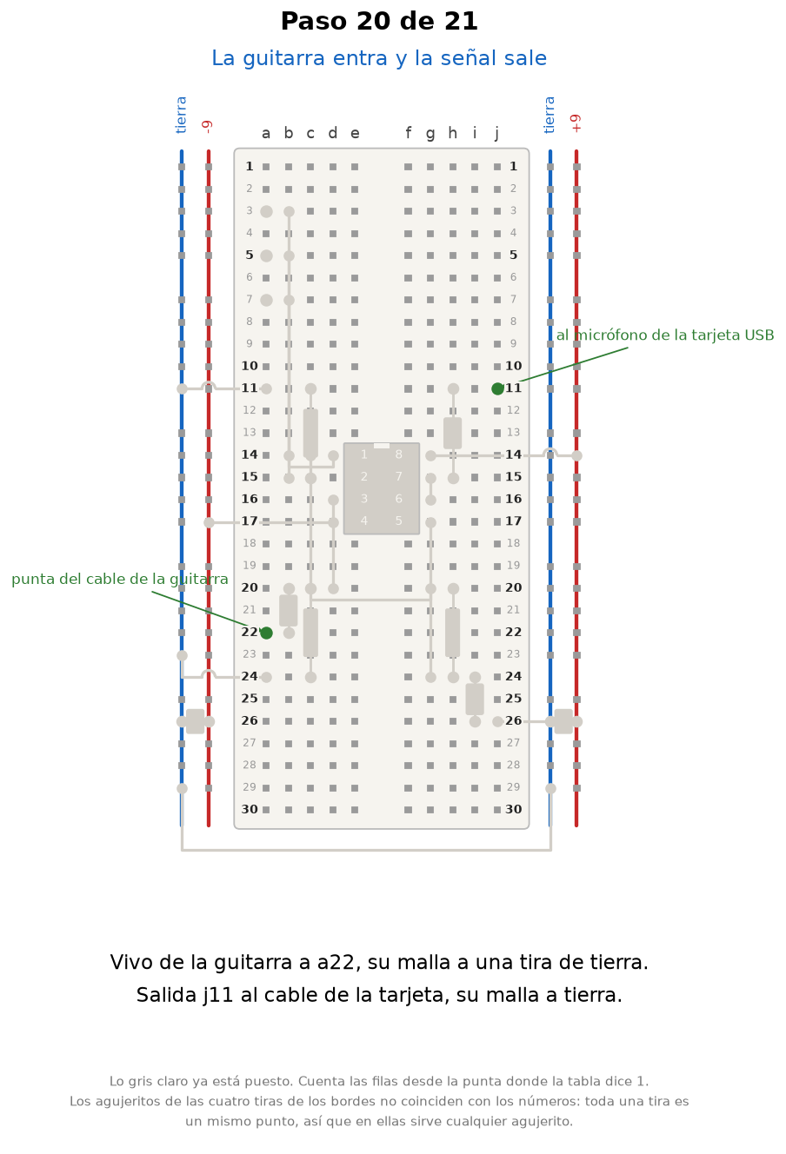
docs/armado/pasos/paso_20.png
