reeenatamc/feuoir-interface/docs/armado/pasos/paso_21.png

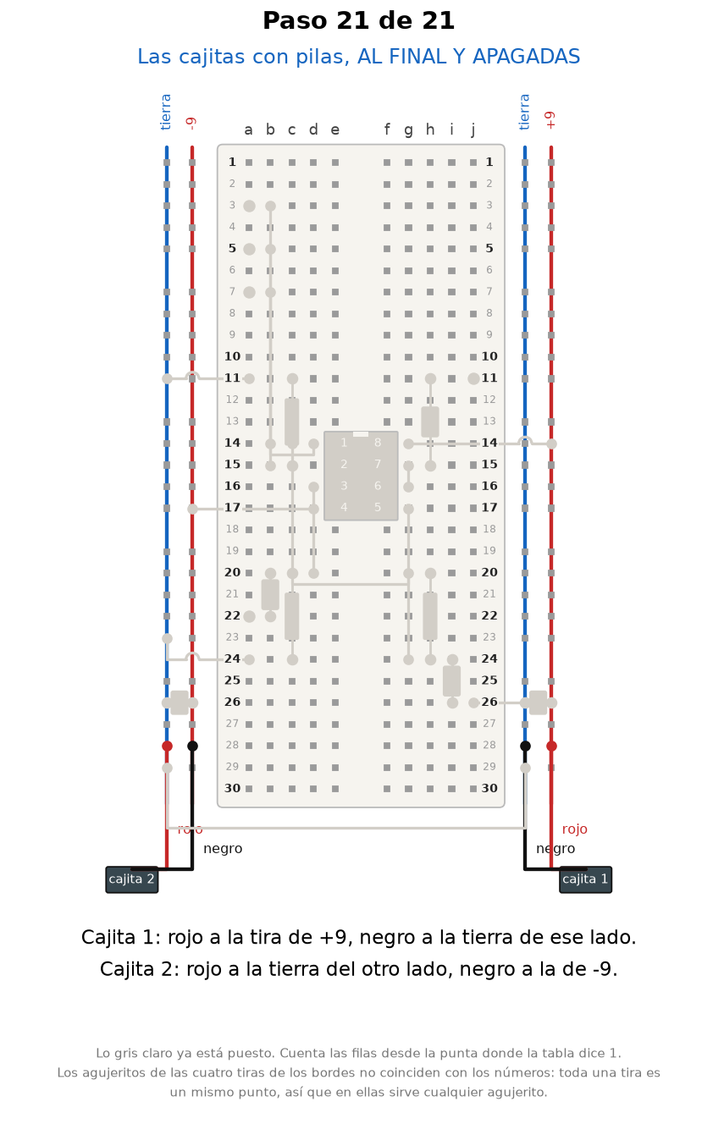
docs/armado/pasos/paso_21.png
