reeenatamc/feuoir-interface/docs/armado/perilla_cables.png

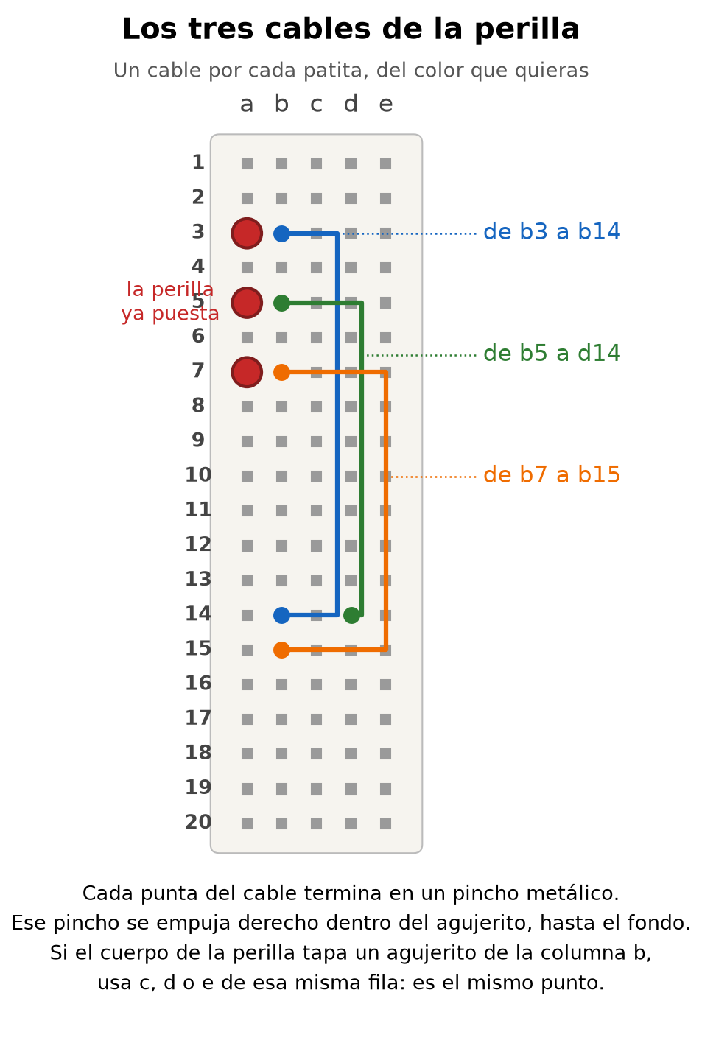
docs/armado/perilla_cables.png
