reeenatamc/feuoir-interface/docs/armado/perilla_donde_va.png

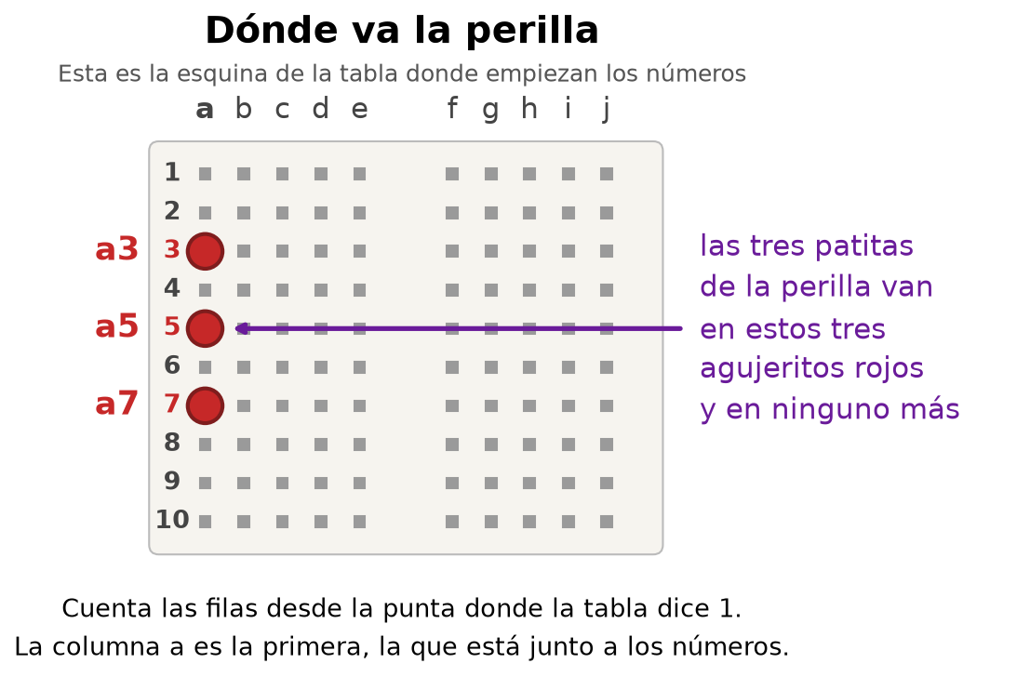
docs/armado/perilla_donde_va.png
