reeenatamc/feuoir-interface/docs/armado/por_que_cada_pieza.png

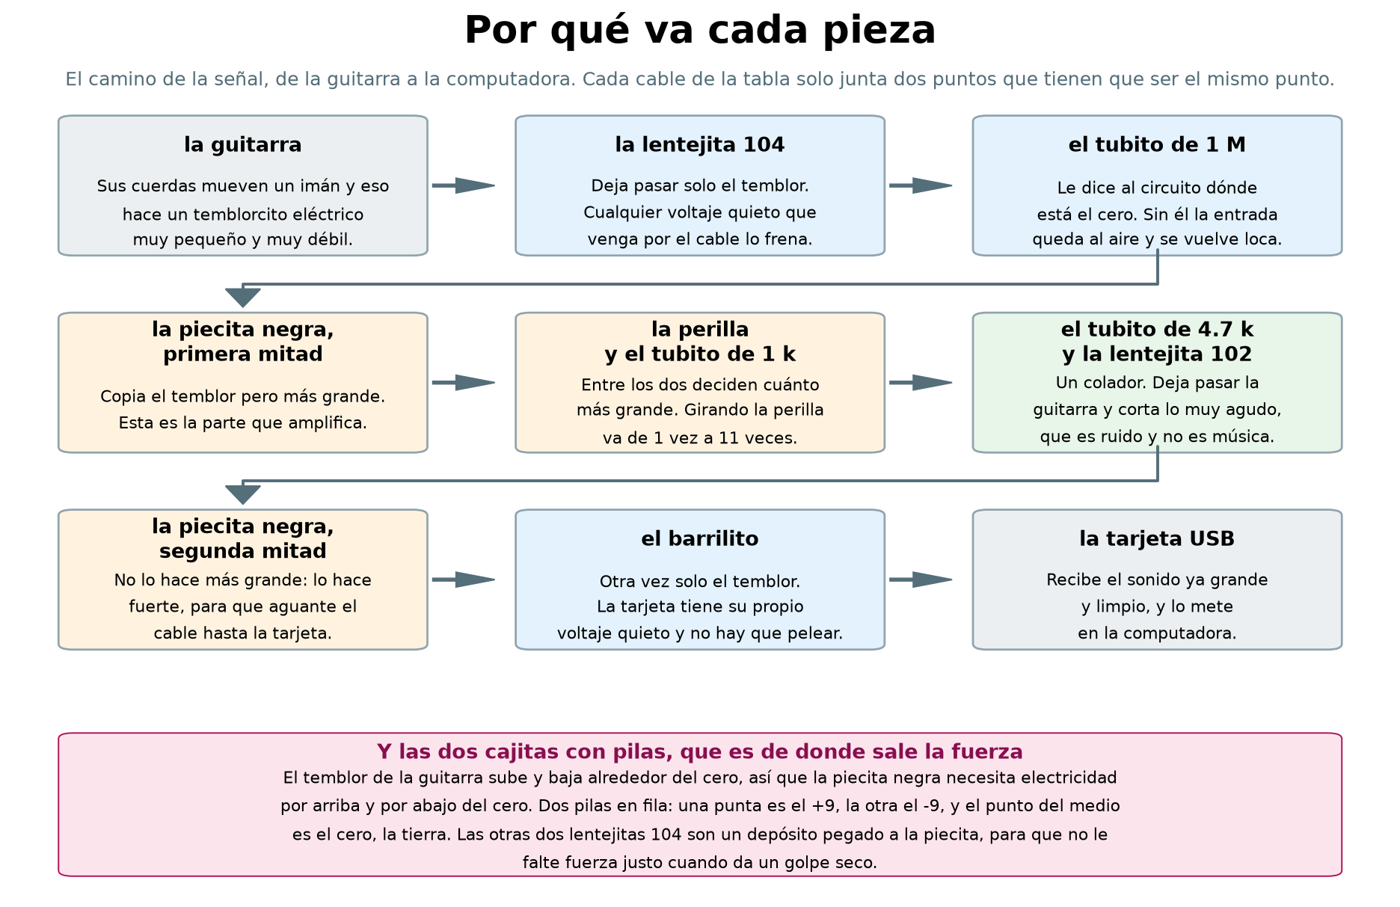
docs/armado/por_que_cada_pieza.png
