reeenatamc/feuoir-interface/docs/armado/resistencia_330.png

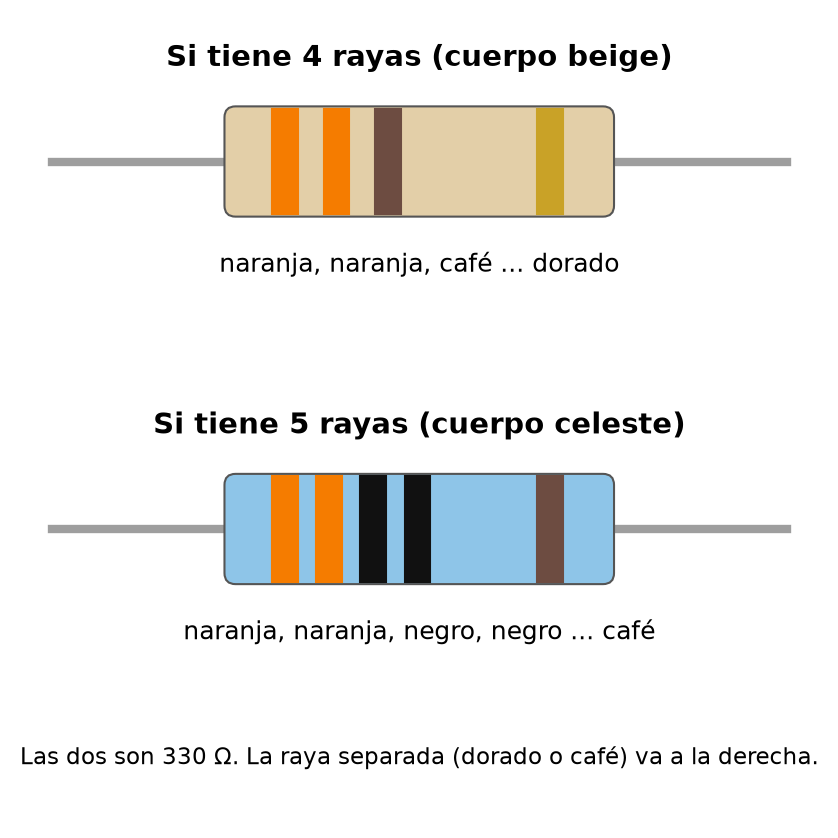
docs/armado/resistencia_330.png
