reeenatamc/feuoir-interface/docs/armado/simbolo_pitido.png

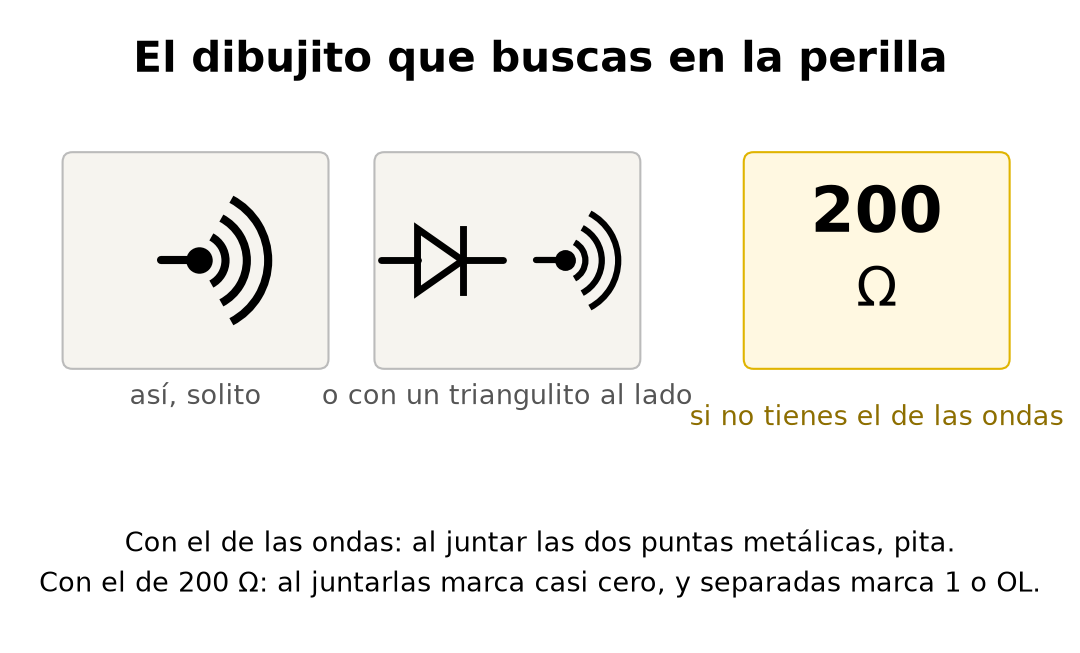
docs/armado/simbolo_pitido.png
