reeenatamc/feuoir-interface/calibraciones/2026-09-14-modelos-tl072/inversion-de-fase-tl072.png

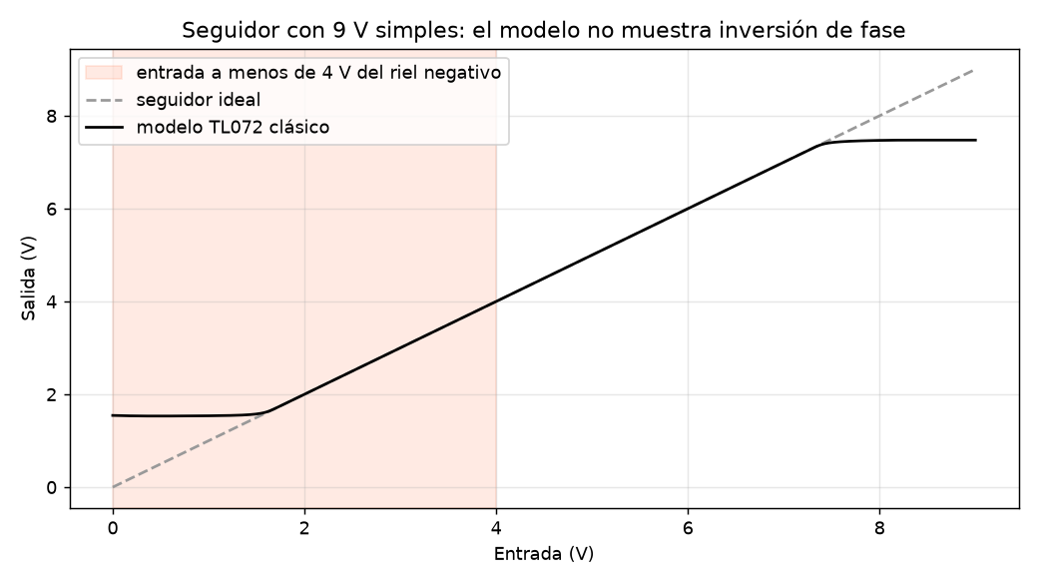
calibraciones/2026-09-14-modelos-tl072/inversion-de-fase-tl072.png
