reeenatamc/feuoir-interface/calibraciones/2026-09-14-modelos-tl072/ruido-tl072h.png

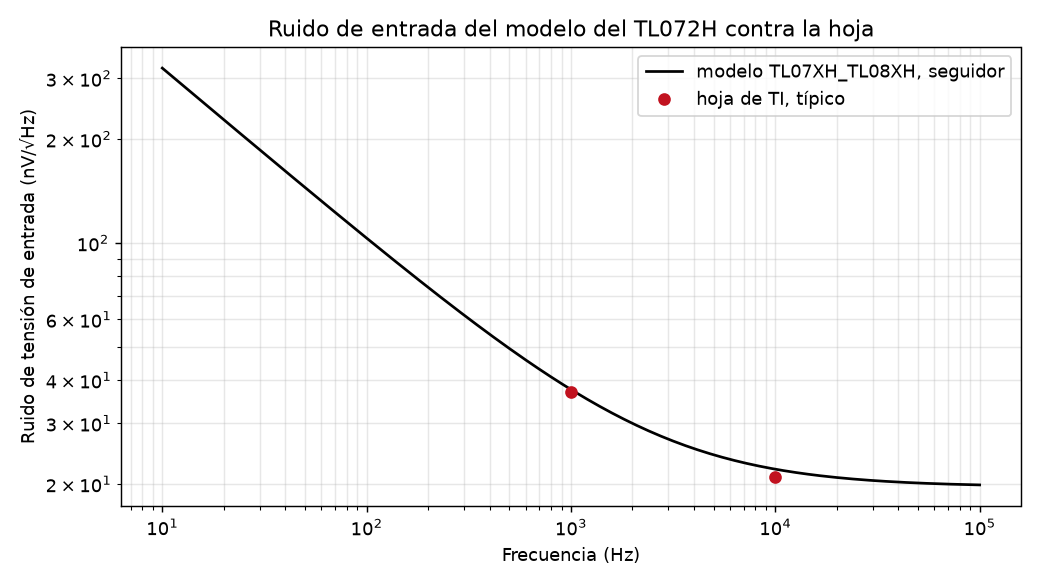
calibraciones/2026-09-14-modelos-tl072/ruido-tl072h.png
