reeenatamc/feuoir-interface/docs/armado/prueba_pitido.png

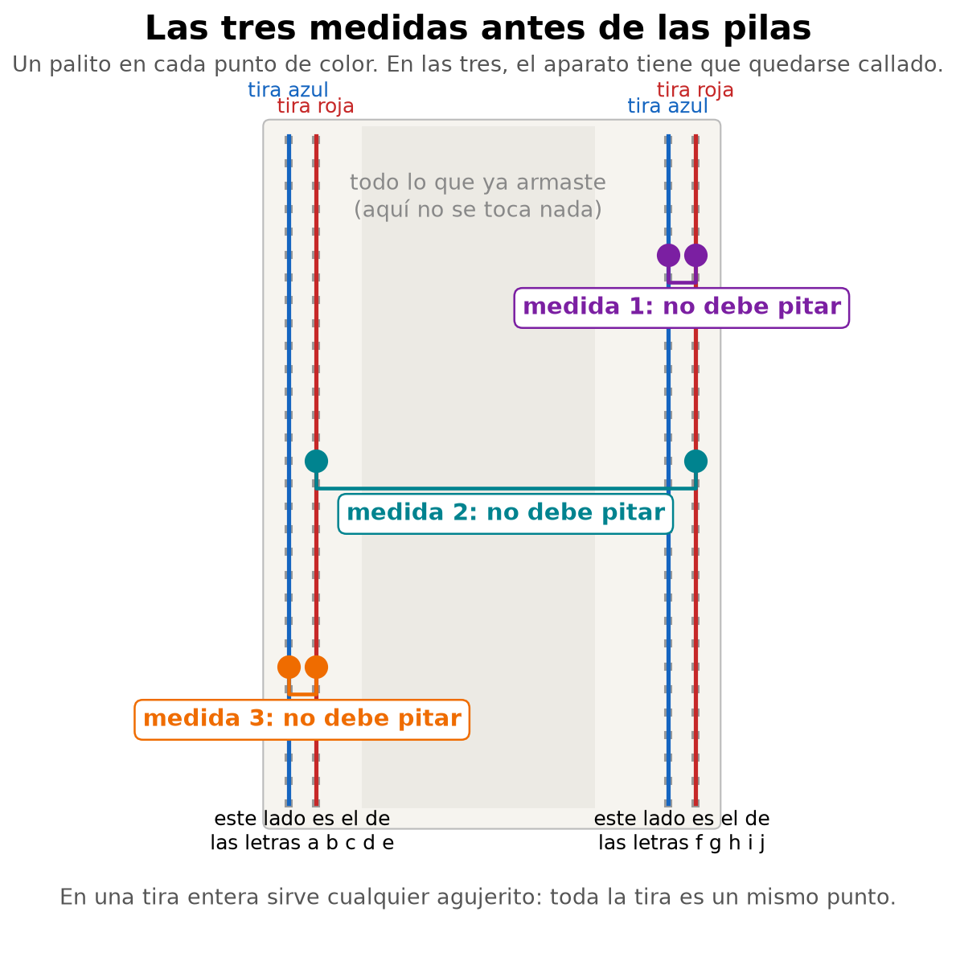
docs/armado/prueba_pitido.png
