reeenatamc/feuoir-interface/docs/armado/etapa_entrada.pdf

## Etapa de entrada de feuoir, versión de ±9 V (spice/netlists/input_stage.cir)

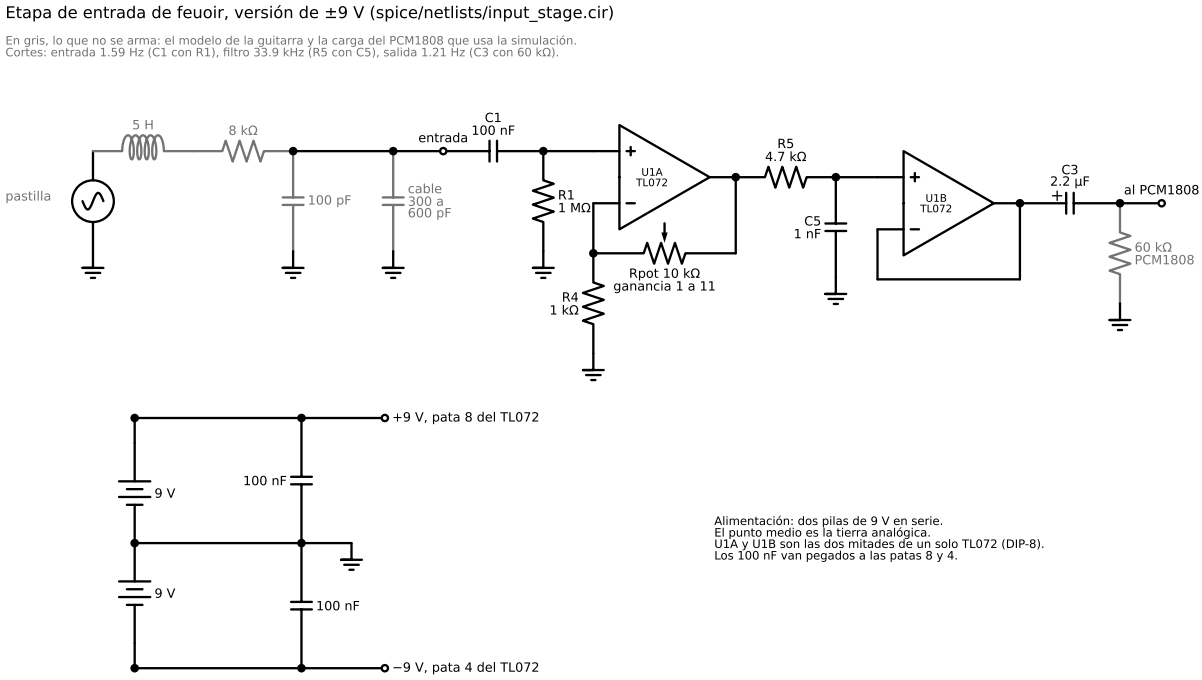
[picture p58: page 1]

En gris, lo que no se arma: el modelo de la guitarra y la carga del PCM1808 que usa la simulación.
Cortes: entrada 1.59 Hz (C1 con R1), filtro 33.9 kHz (R5 con C5), salida 1.21 Hz (C3 con 60 kΩ).

Alimentación: dos pilas de 9 V en serie.
El punto medio es la tierra analógica.
U1A y U1B son las dos mitades de un solo TL072 (DIP-8).
Los 100 nF van pegados a las patas 8 y 4.
