reeenatamc/feuoir-interface/mediciones/2026-09-23-sim-carga-guitarra/netlists/10k-600pf.cir

* Guitar alone, loaded with 10k Ohm, 600pF cable
.include guitar.cir

Vemf emf 0 DC 0 AC 1
Xguitar emf out guitar params: ccable=600p
Rload out 0 10k

.control
set noaskquit
set filetype=ascii
ac dec 100 1 1meg
write ac.raw v(out)
quit
.endc

.end
