reeenatamc/feuoir-interface/firmware/tono_usb_descriptors.c

// USB descriptors for tono_usb: a stereo UAC2 microphone at 48 kHz, 24 bits in 4-byte subslot.
// Adapted from TinyUSB audio_test example (TUD_AUDIO_MIC_ONE_CH_DESCRIPTOR in usbd.h), scaled from
// one channel to two using the two-channel feature unit from the same file.

#include <string.h>

#include "bsp/board_api.h"
#include "tusb.h"

// PID from TinyUSB development example, not assigned to feuoir. Used until a proper one is assigned.
#define USB_VID 0xCafe
#define USB_PID 0x4001

tusb_desc_device_t const desc_device = {
    .bLength = sizeof(tusb_desc_device_t),
    .bDescriptorType = TUSB_DESC_DEVICE,
    .bcdUSB = 0x0200,

    // IAD for audio: Misc class, subclass and IAD as per USB spec.
    .bDeviceClass = TUSB_CLASS_MISC,
    .bDeviceSubClass = MISC_SUBCLASS_COMMON,
    .bDeviceProtocol = MISC_PROTOCOL_IAD,
    .bMaxPacketSize0 = CFG_TUD_ENDPOINT0_SIZE,

    .idVendor = USB_VID,
    .idProduct = USB_PID,
    .bcdDevice = 0x0100,

    .iManufacturer = 0x01,
    .iProduct = 0x02,
    .iSerialNumber = 0x03,

    .bNumConfigurations = 0x01};

uint8_t const *tud_descriptor_device_cb(void) {
    return (uint8_t const *)&desc_device;
}

enum {
    ITF_NUM_AUDIO_CONTROL = 0,
    ITF_NUM_AUDIO_STREAMING,
    ITF_NUM_TOTAL
};

#define EPNUM_AUDIO 0x01
#define CONFIG_TOTAL_LEN (TUD_CONFIG_DESC_LEN + CFG_TUD_AUDIO_FUNC_1_DESC_LEN)

// Stereo input (two-channel UAC2 microphone), copied from TUD_AUDIO_MIC_ONE_CH_DESCRIPTOR but with
// two-channel feature unit and channel fields.
uint8_t const desc_configuration[] = {
    TUD_CONFIG_DESCRIPTOR(1, ITF_NUM_TOTAL, 0, CONFIG_TOTAL_LEN, 0x00, 100),

    TUD_AUDIO_DESC_IAD(ITF_NUM_AUDIO_CONTROL, 0x02, 0x00),
    TUD_AUDIO_DESC_STD_AC(ITF_NUM_AUDIO_CONTROL, 0x00, 0x00),
    TUD_AUDIO_DESC_CS_AC(0x0200, AUDIO_FUNC_MICROPHONE,
                          TUD_AUDIO_DESC_CLK_SRC_LEN + TUD_AUDIO_DESC_INPUT_TERM_LEN + TUD_AUDIO_DESC_OUTPUT_TERM_LEN + TUD_AUDIO_DESC_FEATURE_UNIT_TWO_CHANNEL_LEN,
                          AUDIO_CS_AS_INTERFACE_CTRL_LATENCY_POS),
    TUD_AUDIO_DESC_CLK_SRC(0x04, AUDIO_CLOCK_SOURCE_ATT_INT_FIX_CLK,
                           (AUDIO_CTRL_R << AUDIO_CLOCK_SOURCE_CTRL_CLK_FRQ_POS), 0x01, 0x00),
    TUD_AUDIO_DESC_INPUT_TERM(0x01, AUDIO_TERM_TYPE_IN_GENERIC_MIC, 0x03, 0x04,
                               /*_nchannelslogical*/ 0x02,
                               /*_channelcfg*/ AUDIO_CHANNEL_CONFIG_FRONT_LEFT | AUDIO_CHANNEL_CONFIG_FRONT_RIGHT,
                               0x00, AUDIO_CTRL_R << AUDIO_IN_TERM_CTRL_CONNECTOR_POS, 0x00),
    TUD_AUDIO_DESC_OUTPUT_TERM(0x03, AUDIO_TERM_TYPE_USB_STREAMING, 0x01, 0x02, 0x04, 0x0000, 0x00),
    TUD_AUDIO_DESC_FEATURE_UNIT_TWO_CHANNEL(
        0x02, 0x01,
        /*_ctrlch0master*/ AUDIO_CTRL_RW << AUDIO_FEATURE_UNIT_CTRL_MUTE_POS | AUDIO_CTRL_RW << AUDIO_FEATURE_UNIT_CTRL_VOLUME_POS,
        /*_ctrlch1*/ AUDIO_CTRL_RW << AUDIO_FEATURE_UNIT_CTRL_MUTE_POS | AUDIO_CTRL_RW << AUDIO_FEATURE_UNIT_CTRL_VOLUME_POS,
        /*_ctrlch2*/ AUDIO_CTRL_RW << AUDIO_FEATURE_UNIT_CTRL_MUTE_POS | AUDIO_CTRL_RW << AUDIO_FEATURE_UNIT_CTRL_VOLUME_POS,
        0x00),

    TUD_AUDIO_DESC_STD_AS_INT((uint8_t)(ITF_NUM_AUDIO_CONTROL + 1), 0x00, 0x00, 0x00),
    TUD_AUDIO_DESC_STD_AS_INT((uint8_t)(ITF_NUM_AUDIO_CONTROL + 1), 0x01, 0x01, 0x00),
    TUD_AUDIO_DESC_CS_AS_INT(0x03, AUDIO_CTRL_NONE, AUDIO_FORMAT_TYPE_I, AUDIO_DATA_FORMAT_TYPE_I_PCM,
                              /*_nchannelsphysical*/ 0x02,
                              /*_channelcfg*/ AUDIO_CHANNEL_CONFIG_FRONT_LEFT | AUDIO_CHANNEL_CONFIG_FRONT_RIGHT,
                              0x00),
    TUD_AUDIO_DESC_TYPE_I_FORMAT(CFG_TUD_AUDIO_FUNC_1_N_BYTES_PER_SAMPLE_TX, 24),
    TUD_AUDIO_DESC_STD_AS_ISO_EP(0x80 | EPNUM_AUDIO,
                                  (uint8_t)((uint8_t)TUSB_XFER_ISOCHRONOUS | (uint8_t)TUSB_ISO_EP_ATT_ASYNCHRONOUS | (uint8_t)TUSB_ISO_EP_ATT_DATA),
                                  CFG_TUD_AUDIO_EP_SZ_IN, 0x01),
    TUD_AUDIO_DESC_CS_AS_ISO_EP(AUDIO_CS_AS_ISO_DATA_EP_ATT_NON_MAX_PACKETS_OK, AUDIO_CTRL_NONE,
                                 AUDIO_CS_AS_ISO_DATA_EP_LOCK_DELAY_UNIT_UNDEFINED, 0x0000),
};

uint8_t const *tud_descriptor_configuration_cb(uint8_t index) {
    (void)index;
    return desc_configuration;
}

enum {
    STRID_LANGID = 0,
    STRID_MANUFACTURER,
    STRID_PRODUCT,
    STRID_SERIAL,
};

char const *string_desc_arr[] = {
    (const char[]){0x09, 0x04}, // 0: English (0x0409)
    "feuoir",                   // 1: manufacturer
    "feuoir",                   // 2: product
    NULL,                       // 3: serial, from unique ID if available
};

static uint16_t _desc_str[32 + 1];

uint16_t const *tud_descriptor_string_cb(uint8_t index, uint16_t langid) {
    (void)langid;
    size_t chr_count;

    switch (index) {
        case STRID_LANGID:
            memcpy(&_desc_str[1], string_desc_arr[0], 2);
            chr_count = 1;
            break;

        case STRID_SERIAL:
            chr_count = board_usb_get_serial(_desc_str + 1, 32);
            break;

        default:
            if (!(index < sizeof(string_desc_arr) / sizeof(string_desc_arr[0]))) return NULL;

            const char *str = string_desc_arr[index];

            chr_count = strlen(str);
            size_t const max_count = sizeof(_desc_str) / sizeof(_desc_str[0]) - 1;
            if (chr_count > max_count) chr_count = max_count;

            for (size_t i = 0; i < chr_count; i++) {
                _desc_str[1 + i] = str[i];
            }
            break;
    }

    _desc_str[0] = (uint16_t)((TUSB_DESC_STRING << 8) | (2 * chr_count + 2));

    return _desc_str;
}
