reeenatamc/feuoir-interface/(commit log)

2026-09-13 Agrega medir.py para medir la entrada de audio
    Graba 5 s a 48 kHz, calcula pico y RMS en dBFS y guarda en
    mediciones/<fecha>-<etiqueta>/ el audio, la gráfica y condiciones.json
    con fecha, dispositivo, frecuencia de muestreo y volumen de entrada.
    dispositivos.py lista las entradas de audio.
    DECISIONES.md registra la entrada por tarjeta de sonido USB y el uso
    del micrófono interno solo para validar el script.
2026-09-13 Extrae el análisis a analizador.py
    medir.py toma de analizador.py el pico, el RMS y el espectro. El módulo
    suma THD+N relativo a la fundamental, SNR con dos capturas, ajuste de
    senoidal por mínimos cuadrados (IEEE 1057), respuesta en frecuencia con
    barrido escalonado y generadores de tono y barrido para excitar el
    circuito.
    El espectro de captura.png pasa de dB relativos a su máximo a dBFS
    absolutos: las gráficas de antes de este commit no son comparables con
    las de después.
2026-09-13 Agrega calibrar.py para verificar analizador.py con señales sintéticas
    Cada función del análisis se prueba contra una señal de resultado
    conocido: senoidal de amplitud A, armónico al 1 %, ruido de varianza
    conocida, dos tonos separados 2 Hz, SNR, THD+N con ruido, generadores y
    un Butterworth de respuesta exacta. Cada chequeo se guarda con sus
    condiciones en calibraciones/<fecha>-calibracion/resultados.json y el
    script termina con código 1 si alguno se sale de tolerancia.
    Incluye las dos corridas del 2026-09-13: 169 chequeos, y 170 después de
    agregar el caso del pico en la excursión negativa.
2026-09-13 Agrega relojes.py con la búsqueda del reloj maestro del PCM1808
    Recorre las 941.535 combinaciones del PLL del RP2040 y calcula el
    divisor del PIO que da 12.288 MHz o 24.576 MHz exactos. Marca aparte las
    restricciones que agrega la hoja de datos y calcula la irregularidad del
    divisor delta-sigma en régimen estable. Escribe docs/reloj.md y la lista
    completa en docs/reloj-soluciones.csv.
    Para 24.576 MHz no hay ninguna solución con divisor entero.
    [reloj-soluciones.csv]
2026-09-13 Documenta en el README el toolchain del Pico
    Procedimiento que compiló blink.uf2 en macOS 26.5.2 sobre Intel:
    pico-sdk 2.3.1 con TinyUSB, Arm GNU Toolchain 14.2.rel1 (la última con
    build para Mac Intel), picotool 2.3.1 instalado aparte y CMake 4.4.3.
2026-09-13 Agrega las hojas de datos y la bitácora del proyecto
    docs/datasheets/ guarda la revisión exacta sobre la que se diseña:
    PCM1808 (SLES177B), PCM5102A (SLAS859C), TL072 (SLOS080W) y RP2040
    (build 2025-02-20). docs/bitacora.md tiene una entrada por fase con qué
    se midió, en qué condiciones, qué se decidió y por qué.
2026-09-13 Ignora las capturas de audio
    Los .wav de las mediciones quedan fuera del repo. .venv ya estaba
    ignorado.
2026-09-13 Cambia el reloj maestro a GPOUT0 por GPIO21 con DC50
    La solución elegida pasa a ser clk_sys de 61.44 MHz dividido por 5 en
    GPOUT0: divisor entero, ciclo de trabajo de 50 % con DC50 y una máquina
    de estados del PIO libre para el I2S. El PIO a 24.576 MHz con divisor
    2.5 queda documentado como respaldo.
    firmware/ configura el reloj y escribe DC50 a mano, porque
    clock_gpio_init_int_frac8 del SDK 2.3.1 no lo activa. relojes.py suma
    el camino de GPOUT0 y ahora solo reescribe el bloque entre marcas de
    docs/reloj.md. El documento agrega la corrección sobre el divisor 0.5
    del PIO, el margen de CPU y cómo verificar la frecuencia sin
    osciloscopio.
    [reloj-soluciones.csv]
2026-09-13 Agrega tests/mutaciones.py para comprobar que calibrar.py atrapa errores
    Corre calibrar.py contra copias de analizador.py con 15 errores
    inyectados, uno a la vez, más una copia sin cambios como control. Falla
    si algún error pasa sin detectarse, si el control no pasa o si el texto
    de una mutación ya no existe en analizador.py. Guarda el resultado con
    sus condiciones en calibraciones/<fecha>-mutaciones/resultados.json.
    Incluye la corrida del 2026-09-13: control aprobado y las 15 mutaciones
    detectadas.
    [mutaciones.py]
2026-09-13 Anota en la bitácora el cambio de escala del espectro
    Desde e32c257 el espectro de captura.png está en dBFS absolutos y antes
    estaba en dB relativos a su máximo, así que las gráficas de antes y de
    después no son comparables. pico_dbfs y rms_dbfs de condiciones.json no
    cambiaron.
2026-09-13 Verifica THD+N en banda angosta y agrega la mutación del borde inferior
    calibrar.py suma test_thd_n_banda_angosta: bandas laterales a ±100 Hz
    de un tono de 1 kHz y componentes fuera de la banda de 800 a 1200 Hz.
    Ninguna prueba usaba el borde inferior de la banda, y un filtro que no
    cortara abajo pasaba la calibración. Ahora lo atrapa esta prueba y
    queda como mutación banda_inferior_ignorada en tests/mutaciones.py.
    Incluye las corridas del 2026-09-13: 12 pruebas con 172 chequeos y 16
    mutaciones detectadas.
2026-09-13 Analiza el jitter del reloj maestro y agrega jitter.py
    jitter.py simula capturas de un tono muestreado con jitter conocido y
    las mide con analizador.py: jitter blanco, lento y periódico, con
    muestreo directo a fS y a 64 fS con decimación. Los 19 casos coinciden
    con la teoría.
    docs/reloj.md suma qué dicen las hojas del PCM1808 y del RP2040 sobre
    jitter (ninguna da números de desempeño), cuánto jitter se notaría con
    este ADC y cómo detectarlo: thd_n con tono y en banda angosta, no
    snr_db con captura sin señal.
    [jitter.py]
2026-09-13 Prevé un oscilador externo de 12.288 MHz para comparar contra GPOUT0
    docs/reloj.md suma el punto de conexión: un jumper de 3 pines para
    elegir SCKI entre GPOUT0 y un oscilador de cristal externo, y un jumper
    en la alimentación del oscilador. También las condiciones para que la
    comparación sea justa: PCM1808 en modo maestro a 256 fS con las dos
    fuentes, la fuente que no se usa apagada y el jumper cambiado sin
    alimentación.
    La opción FEUOIR_RELOJ_EXTERNO de CMake compila el firmware con GPOUT0
    apagado y clk_sys igual, para que entre las dos mediciones solo cambie
    SCKI.
2026-09-13 Agrega el firmware de verificación del reloj maestro, sin probar en placa
    firmware/verificar_reloj.c hace los pasos 1 y 2 de la verificación sin
    osciloscopio: imprime por USB los registros del PLL y de GPOUT0 leídos
    de vuelta, la salida del PLL medida con el contador de frecuencia del
    RP2040 y la frecuencia que entra por GPIO20. Compilado con
    FEUOIR_RELOJ_EXTERNO mide el oscilador externo.
    La parte que decodifica y juzga está en firmware/informe.c, sin acceso
    a hardware, y tests/verificacion_sin_placa.py la prueba en la Mac con
    11 casos. Compila sin avisos en las dos variantes. La lectura real de
    registros y el contador solo se pueden probar en la placa.
2026-09-13 Agrega leer_verificacion.py para guardar el informe del reloj con sus condiciones
    Lee por el puerto USB un informe completo del firmware de verificación
    y lo guarda en mediciones/<fecha>-<etiqueta>/ con informe.txt y
    condiciones.json, igual que medir.py. --puentes es obligatorio porque
    el firmware no puede saber cómo están los puentes. Termina con código 1
    si el informe trae fallas o si no llega completo.
    tests/lectura_sin_placa.py lo prueba con un pseudo terminal y con
    informes que genera firmware/informe.c compilado en la Mac: 13 casos.
2026-09-13 Agrega prueba_jitter: la pendiente del THD+N contra la frecuencia como procedimiento
    analizador.prueba_jitter mide THD+N en una banda de ±400 Hz alrededor
    de cada tono de 1 a 10 kHz, ajusta razón² = a·f² + b y responde
    compatible_con_jitter, sin_efecto_detectable o no_compatible, con la
    pendiente en dB por década y el jitter RMS equivalente. Es la prueba
    para comparar GPOUT0 contra el oscilador externo.
    calibrar.py la valida con capturas de jitter conocido: 19.88 dB por
    década y 1.002 ns con 1 ns de jitter, sin efecto con solo ruido y no
    compatible con ruido que crece 40 dB por década. Cuatro mutaciones
    nuevas la atacan y las 20 quedan detectadas.
    [analizador.py, calibrar.py, mutaciones.py]
2026-09-13 Documenta un solo dominio de reloj con el PCM5102A en modo de 3 hilos
    Con SCK a tierra, el PCM5102A arranca su PLL a partir del BCK que genera
    el PCM1808 en modo maestro (sección 9.3.5.3 de su hoja), y 64 BCK por
    trama a 48 kHz está en su tabla 11. Captura y reproducción quedan en un
    solo dominio de reloj y el Pico es esclavo por los dos lados.
    docs/dominio-de-reloj.md trae el diagrama de conexiones, los niveles de
    MD0, MD1, FMT, FLT, DEMP y XSMT, los puentes del módulo según fuentes de
    la comunidad, la temporización estimada del Pico como esclavo y la duda
    del historial de revisiones sobre 48 kHz con la PLL.
2026-09-13 Documenta el audio USB asíncrono para un reloj de audio propio
    El reloj del PCM1808 nunca coincide exacto con el de la Mac, así que el
    búfer deriva. docs/audio-usb.md explica cómo lo resuelve USB Audio
    Class en este caso: captura con endpoint IN asíncrono, que lleva su
    ritmo en la cantidad de muestras por paquete, y reproducción con
    realimentación explícita (10.14 en 3 bytes en velocidad completa) o
    implícita, que corresponde porque ADC y DAC comparten reloj.
    Compara lo que soportan TinyUSB 0.18.0, 0.19.0 y 0.20.0 en adelante
    contra la nota técnica TN3190 de Apple, y revisa cómo lo hace
    tierneytim/Pico-USB-audio, que descarta o repite muestras. Propone
    TinyUSB 0.19.0 con realimen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
2026-09-13 Numera la bitácora por entradas y no por fases
    Las entradas estaban tituladas Fase 0 a Fase 15 en el orden de trabajo,
    y eso chocaba con las fases del proyecto, donde la captura por USB es
    la fase 5 y la reproducción la fase 6. Pasan a llamarse Entrada 0 a 15,
    con las referencias internas actualizadas.
2026-09-13 Anota la decisión de quedarse en TinyUSB 0.18.0 y el margen propio del diseño
    La captura de la fase 5 no necesita realimentación, así que se hace con
    la TinyUSB 0.18.0 del pico-sdk. El cambio de versión se evalúa en la
    fase 6 contra una base que ya funciona y está medida. Queda anotado lo
    investigado de 0.19.0 a 0.21.0 para no repetirlo.
    El rango de 47 a 49 muestras por milisegundo está confirmado en la
    especificación de formatos de UAC1, pero la arquitectura no se apoya en
    él: ajustes de una sola muestra y espaciados, FIFO regulada a la mitad y
    registro por sesión del margen que se usa.
2026-09-13 Agrega el jumper de SCK del PCM5102A: 3 hilos con PLL o 4 hilos con SCKI
    El nodo de SCKI llega también al SCK del PCM5102A por un jumper de 3
    pines que lo pone en SCKI o a tierra. La duda del historial de
    revisiones sobre 48 kHz con la PLL se elimina por diseño: con SCK en
    SCKI el DAC usa el mismo reloj maestro que el ADC y sigue siendo
    sincrónico. El puente de SCK del módulo tiene que quedar abierto.
2026-09-13 Reescribe el inicio del README para quien llega de cero
    Qué es el proyecto, cómo está armado, el estado de cada parte con lo
    probado y lo que falta probar, la estructura del repo y las
    convenciones.
2026-09-13 Agrega resistencias en serie en las líneas digitales y la lista de compras
    Una resistencia pegada al pin que maneja cada línea entre el Pico y los
    módulos: 330 Ω en las dos líneas de reloj maestro y 470 Ω en BCK, LRCK,
    DOUT y DIN. Limitan la corriente con el destino en corto a 10 y 7 mA,
    debajo de los 12 mA con que el RP2040 especifica sus salidas y de los
    ±10 mA máximos del PCM1808, y a 12.288 MHz corren el ciclo de trabajo
    de SCKI menos de 5 puntos mientras el nodo sume hasta 25 pF.
    docs/dominio-de-reloj.md trae el cálculo y el diagrama con R1 a R6.
    docs/compras.md es nueva: no había lista en el repo. Se suma la hoja de
    datos de la placa Raspberry Pi Pico.
2026-09-13 Agrega la lista de primer encendido
    docs/primer-encendido.md es una lista para seguir paso a paso: revisión
    con multímetro antes de enchufar, con el puente de SCK del módulo del
    PCM5102A como revisión principal; encendido por etapas, el Pico solo, el
    reloj, el ADC y el DAC, con qué conectar, qué medir y qué valor esperar;
    dónde usar el firmware de verificación y el puente a GPIO20; qué no
    hacer y qué síntomas obligan a desenchufar. El README suma el estado y
    las referencias a esta lista y a la de compras.
2026-09-13 Decide la cáscara de la app de medición en vivo
    Python sirve la página y el WebSocket con aiohttp desde el mismo proceso
    que lee el audio y analiza, y pywebview la muestra en una ventana
    propia. Se descarta Tauri, porque Python correría como sidecar
    empaquetado con PyInstaller detrás de una cáscara en Rust, y Electron,
    porque embebe Chromium y Node.js en una Mac que ya anda al límite de
    memoria. Todavía sin código.
2026-09-13 Agrega la app de medición en vivo: fuente sintética, procesado, mediciones y servidor, con su prueba por WebSocket
2026-09-13 Agrega la interfaz de la app con el registro de feuoir en los menús y los ajustes
2026-09-13 Suma a tests/mutaciones.py siete errores que atacan la app
    [mutaciones.py]
2026-09-13 Documenta la app de medición en vivo: cómo abrirla, cómo está hecha y qué quedó probado
2026-09-13 Anota que la app ya corrió con el micrófono interno de la Mac
2026-09-14 Pasa la app a código en inglés, suma las mediciones guardadas y corrige el canvas en modo oscuro
    [__main__.py, app_contract.py, measurements.py, mutaciones.py, processing.py, server.py, sources.py]
2026-09-14 Documenta las mediciones guardadas, el contrato 2 y la regla de código en inglés
2026-09-14 Suma a la app la elección de la salida del estímulo
2026-09-14 Documenta la salida del estímulo elegible
2026-09-14 Anota el rango de entrada del TL072 y el paso a alimentación partida de ±9 V
2026-09-14 Acepta el TL072 DIP-8 de 37 nV/√Hz y fija las condiciones para simular la entrada
2026-09-14 Decide el simulador del circuito analógico: ngspice 47 en batch, compilado sin interfaz
2026-09-14 Agrega la simulación con ngspice y su verificación contra la teoría
2026-09-14 Documenta la instalación de ngspice, su verificación y lo que se sabe de los modelos del TL072
2026-09-14 Caracteriza los dos modelos del TL072 y deja escrito para qué se usa cada uno
2026-09-14 Simula la etapa de entrada: respuesta en frecuencia, transitorio, ruido y carga de la guitarra, con chequeos contra el cálculo a mano
    [datos-partida-7v.csv, datos-partida-9v.csv, datos-simple-9v.csv, datos.csv]
2026-09-19 Hace que medir.py y dispositivos.py corran en Windows y guarda el entorno de cada medición
    Las mediciones pasan a hacerse en dos máquinas, la Mac y una laptop ASUS con Windows con
    una tarjeta de sonido USB externa, así que hacía falta que los mismos scripts corrieran en
    las dos y que cada captura dijera dónde y cómo se tomó.
    - dispositivos.py lista cada entrada con su índice, nombre, API de audio, canales,
    frecuencia y si acepta un canal a 48 kHz, y marca la API recomendada de cada sistema:
    WASAPI en Windows, Core Audio en la Mac. En Windows el mismo aparato aparece una vez por
    API y hay que poder distinguirlas.
    - condiciones.json guarda el sistema operativo, la API de audio y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
2026-09-19 Lee el volumen y la ganancia de cualquier entrada, busca la tarjeta por nombre y descarta el golpe del arranque
2026-09-19 Mide la tarjeta USB y la guitarra: pisos de ruido, lazo de tierra del cargador y primeras notas
2026-09-19 Guarda notas en cada medición de la app, validadas en el servidor y con su mutación
2026-09-19 Primer encendido del Pico, etapas 1 y 2: el reloj de 12.288 MHz llega a GP20 por R1 con 0.0 ppm
2026-09-19 medir.py graba cualquier entrada por nombre y elige el canal con --dispositivo y --canal
2026-09-19 El Pico aparece en la Mac como micrófono USB con un tono de 1 kHz que llega idéntico, muestra por muestra
2026-09-19 Las pruebas de la app importan device_volume solo en macOS, para que corran también en Windows
2026-09-19 Analiza las tomas de guitarra: zumbido de la red, espectro promediado, puntos de caída y notas
2026-09-19 Dibuja el esquema de la etapa de entrada de ±9 V a partir de la netlist de SPICE
2026-09-24 Mide la resistencia de las pastillas y repite las simulaciones con ese valor
    Las cinco posiciones del selector dan de 4.96 a 12.60 kOhm, y las
    combinaciones cuadran con el paralelo de las pastillas solas. El modelo
    de la guitarra pasa de 8 kOhm supuestos a 12.6 kOhm medidos: la
    resonancia se amortigua entre 1.8 y 2.4 dB y la caida de 3 dB con carga
    de 10 kOhm se corre de 593 a 737 Hz.
    [datos-partida-7v.csv, datos-partida-9v.csv, datos-simple-9v.csv, datos.csv]
2026-09-24 Dibuja el armado de la etapa de entrada sobre la protoboard y completa la lista de compras
    El guion deriva los nodos de la conectividad de la protoboard y
    comprueba que el circuito que arma sea el mismo que simula
    input_stage_split antes de dibujarlo, asi que un cable en el agujero
    equivocado falla ahi y no en la mesa. La lista de compras no tenia las
    pasivas de la etapa.
2026-09-24 Aclara en el dibujo del armado que la etapa va en la MB-102 libre y no en la del Pico
2026-09-24 Dibuja la alimentacion de la etapa de entrada: las dos pilas, los cuatro rieles y donde medir
2026-09-24 Parte el armado de la etapa de entrada en una imagen por paso
2026-09-24 Dibuja las rayitas de colores y el numero impreso en cada paso
2026-09-24 Corrige el sentido del acoplo de salida y arma la etapa con el de 10 uF
2026-09-24 Dibuja las cuatro tiras de los bordes donde la MB-102 las tiene, a los costados
2026-09-24 Dibuja los agujeritos de las tiras de los bordes en cada paso
2026-09-24 Dibuja la perilla y sus tres patitas en el paso 19
2026-09-24 Clava el potenciometro en la protoboard en vez de colgarlo con cables
2026-09-24 Aclara que el cuerpo del potenciometro cuelga por fuera de la tabla
2026-09-24 Anade un acercamiento de los tres agujeritos del potenciometro
2026-09-24 Anade un dibujo de los tres cables de la perilla
2026-09-24 Genera un mapa de que hay en cada agujerito de la protoboard
2026-09-24 Anade el dibujo de las tres medidas previas a las pilas
2026-09-24 Anade el dibujo del simbolo de continuidad del multimetro
2026-09-24 Registra la revision de continuidad de la etapa de entrada
2026-09-24 Explica para que sirve cada pieza de la etapa de entrada
2026-09-24 Anade un camino de estudio de la electronica del proyecto
2026-09-24 Parte el README: deja lo corto y mueve el detalle a docs
2026-09-24 Reescribe el README: que es el proyecto, de donde sale y como levantarlo
